hongpengWu/mlkem-polymul-rv32i-fpga/mainline/k4/skill/README.md

# Validation skill material

This directory contains the supplied PYNQ accelerator validation and overlay contract skill packages. They are auxiliary review and demonstration material; the hardware source and build entry points remain under `mainline/k4/`.
