hongpengWu/mlkem-polymul-rv32i-fpga/docs/ACCEL_KAT_AUTORUN.md

# KAT 无人值守续跑

更新时间：2026-10-26。当前方向是 **K=4 / ML-KEM-1024 主线，K=2 冻结历史对照，
K=3 后置扩展**；K4加速组和同板CPU-only对照均已完成145/145。旧“K3/K4 BaseMul移植后返回K2优化”队列已撤销。
自动续跑 `pqc-kat` 已按用户要求删除，不再周期性发送指令。本文件仅作为人工续接断点。
当前发布分支为 `last`；`24-2hp` 是历史开发分支，原始分支和冻结基线不改。

## 当前人工续接断点（2026-10-16）

板上验证已完成，本文件保留续接规则和历史断点说明，不再启动新的长任务。
加速组 `FULL_PASS 145/145` 证据在 `results/keccak_cpu/board/20261016_full145/`；
同板CPU-only/加速配对证据在 `results/k4/paired_firmware/board_20261023/`。
历史RTL、PS–PL和实板数据仍按证据层级分别引用。

## 已完成

- [x] 512 CPU+PQC：19 批、145/145 唯一覆盖，各批最终 PASS、实际 MMIO 指标和官方输出通过。
  缺失 0–37 已补齐，142–144 已按实际 3 条修复，不要重跑旧 14 批入口。
- [x] 独立证据位于 `results/accelerator_cpu/kat/`，默认 collector 通过；已提交推送 `0b16e76`。
  CPU-only / CPU+PQC 为 692,273,249 / 697,154,629 cycles，端到端 0.992998×。
  核心 46,240、搬入 14,404,780、读回 1,986,620、其余 API/驱动 680,716,989 cycles；后者不能全称轮询。
- [x] 768 RV32IM-fast CPU-only：2026-09-26 17:40 完成 145/145，collector 校验通过。
  算法周期 1,112,525,793，全程周期 1,147,835,590，最大观测栈 18,432 B。
  证据和表格在 `results/official_baseline/mlkem768/rv32im_fast/`。
- [x] K3/K4 参数化固件、fixture 和 TB 已建立，128 KiB RAM、32 KiB 栈。
  1024 RV32I/RV32IM 已编译；RV32IM-fast 官方 RTL 回归已 145/145 通过。

## 1024 RV32IM-fast CPU-only 已完成

- 已按 19 个顺序批次完成：0–7、8–15、…、136–143、144（最后 1 条）。
- 全量 collector 已通过：145/145 唯一覆盖，逐字节官方输出、返回值、M 指令、栈和输入哈希均通过。
- 汇总：算法 1,699,294,360 cycles，全程 1,747,426,461 cycles，最大观测栈 24,464 B；证据在 `results/official_baseline/mlkem1024/rv32im_fast/`。
- 每批证据：`results/official_baseline/mlkem1024/batches/rv32im_fast/batch_*/`。
  实时日志为 `console_<attempt>.txt`；`simulate.log` 可能缓冲至结束，不能因其为空误判停止。
- 构建目录：`build/mlkem_suite/1024/rv32im_fast/<batch>/<attempt>/`，重试使用新目录。
- 每批保存真实 case_count、original_indices、运行前输入哈希、最终 PASS 和 success.json；失败修复时保留旧 attempt。
  Windows 进程锁及活动 Vivado/XSim 检查防止重复调度。
- 新建 `build/mlkem_suite/STOP` 后，在当前批结束时停止启动下一批；恢复前移除标记。
  运行中禁止更改冻结脚本、TB、固件、manifest，禁止终止正常仿真或删除活动目录。

## 当前开发规则（2026-10-04）

- 优先完成K4主线；K3、其他CPU消融等支线后置。
- 日常迭代只跑官方子集（默认索引0、1、115，覆盖KeyGen/Encaps/Decaps）与针对改动的smoke/边界检查。
- 最终候选完成后再跑145条全量验收；子集不能记为145/145。
- 核心/HLS及独立PL流程使用`mainline/k4/flow.tcl`顶部0/1开关，默认`FULL_KAT=0`。
- PS–PL使用独立`mainline/k4/bd_axi.tcl`及`PREPARE/SIM/CREATE_BD/SYNTH/IMPL/EXPORT`开关；
  通过门禁后只发布到`release/mlkem1024_pynq/`，不新增并列部署目录。
- 每个RTL版本使用独立CANDIDATE结果目录；续跑先核对版本，旧结果只供对照。
- 主线稳定后统一整理目录、合并冗余入口；保留原始证据和所需冻结输入。

### PS–PL当前断点

`20261004_psaxi02`实际执行的AXI协议检查与官方索引0、1、115三例已PASS。
`20261004_psaxi04`因复位极性/辅助复位接线及GP0接口元数据问题拒绝作为发布候选；
run05也因GP0元数据拒绝，原证据保留。`20261005_psaxi06`已完成实现与发布，
setup/hold/pulse +0.302/+0.026/+3.750 ns，功能风险DRC为0，29,758条网络全部布线。
LUT/FF/BRAM36等效/DSP为19,759/17,585/34.5/4；配套文件与哈希校验通过。
固定部署目录`release/mlkem1024_pynq/`；项目`E:/hls/k4pynq/20261005_psaxi06/project/k4_pynq.xpr`。
恢复记录及7处隐式LUT配对布局修复见该批次reports；未改写冻结输入，无需重跑旧KAT。
K=4 PYNQ-Z2 overlay 已上传并完成 Notebook 官方全量 `FULL_PASS 145/145`。
实板原始证据位于 `results/keccak_cpu/board/20261016_full145/`；默认三例适合现场演示，全量 JSON 作为归档验收。
此前独立3例PL自检已有用户报告的LED0 PASS和BTN0复位后恢复；这不代替新overlay实测。

### 已冻结的核心断点

`timing_decode_v3`最终官方KAT **145/145** 已通过；19批最终PASS、唯一覆盖、
官方输出、冻结输入哈希和3,188次真实HLS调用已独立复核。API周期CPU/加速为
1,699,294,360 / 446,853,509，3.8028×；证据在
`results/keccak_cpu/candidates/timing_decode_v3/kat/`。断点complete，当前版本无需重跑。
调度日志`build/keccak_cpu/candidates/timing_decode_v3/final145_scheduler.log`；
冻结输入保留在`E:/hls/k4kat_timing_decode_v3/`，19批与板级共用的18项核心/HLS输入哈希一致。
`20261004_121837`完成布线后写DCP异常退出；保留失败证据，从综合检查点恢复实现。
恢复批次`20261004_124354`已保存最终DCP/报告：100 MHz内部setup/hold +0.269/+0.029 ns，
LUT19,003、FF17,005、BRAM36等效34.5、DSP4。全路径hold −1.194 ns仍在OOC resetn边界，
原始`timing_met=false`保留；板级签核已在独立真实MMCM流程完成。
上述145/145与3.8028×均是历史核心RTL证据，不转记为新PS–PL或实板性能。

板级上板前签核证据位于`results/keccak_cpu/board/20261004_162430/`：官方索引0、1、115
三例真实MMCM仿真通过，setup/hold/pulse为+0.109/+0.027/+2.000 ns，路由28,091/28,091，
功能风险DRC为0，bitstream位于`E:/hls/k4board/20261004_162430/board/board.bit`。

## 下一步顺序

1. [x] 1024 已执行 `python scripts/mlkem_suite/collect.py --parameter-set 1024 --write`。
   145 条唯一覆盖、每批最终 PASS、官方字节/返回值、M 指令、栈、周期和哈希全部通过。
2. [x] 更新性能表、覆盖矩阵、路线图。K3/K4 的128/32 KiB与512的64/16 KiB已分开列明。
   768 run_snapshot是事后归档：原run_inputs哈希仿真前捕获，额外源码只属事后快照。
   不改写历史哈希或伪称构建前证据。1024已补齐命令、源码、工具链和链接脚本哈希。
3. [x] 完成首轮 K=4 Keccak/FIPS 202 HLS 精确建模、访存优化和独立 IP OOC 实现。
   主加速器不受旧 BaseMul 范围限制；K=2 的 Keccak 71%–81% 占比只属于 K=2，K=4 尚未测量。
4. [x] K4主机145条官方记录调用统计已完成；CPU＋Keccak接口10次真实RTL调用/216字通过。
   见 [接口与移植断点](MLKEM1024_KECCAK_CPU_INTERFACE.md)。
   [x] 已完成标准库FIPS202适配、固件编译及完整官方RTL KAT145/145。
   官方加速系统入口为`mainline/k4/scripts/run_kat.py`，续跑加`--remaining`，
   日志/证据独立保存在`results/keccak_cpu/kat/`，短路径冻结项目在`E:/hls/k4kat/`。
   当前进程/断点读取`build/keccak_cpu/kat_progress.json`；不要再运行CPU-only批次。
   全部145条唯一覆盖、19批最终PASS、3,188次真实HLS调用（含68次SQUEEZE）均通过。
   当前调度日志`build/keccak_cpu/kat_scheduler_20260927.log`；无定时任务。
   调度器已运行`collect_kat.py --write`严格汇总，人工只读复核也通过；状态complete，无需再启动。
   主机、纯 CPU、局部 `hashlib` 差分或软件回退均不能替代对应加速系统的官方验证。
5. [x] 完成同RV32IM-fast、128 KiB RAM / 32 KiB栈的完整API对照：
   1,699,294,360 / 446,853,509 cycles，3.8028×，包含搬运、启动、等待和读回。
   [x] 已完成同约束完整系统OOC实现，报告在`results/keccak_cpu/system_impl/20260927_194022/`，DCP保留在`E:/hls/k4sys/20260927_194022/`。
   两组资源足够；CPU-only内部setup/hold +1.452/+0.051 ns，加速组 −1.367/+0.050 ns。
   [x] 当前v3已解耦程序RAM写控制和adapter ready反馈、简化MMIO译码，组件/子集/同例周期通过；原145条证据不改写。
   [x] 当前v3内部100 MHz时序已通过；完整布线与pulse width检查通过。
   [x] 完成板级边界/时钟复位集成、3条官方子集、实现签核和bitstream；当前核心最终145条已验收。
   板级setup/hold/pulse +0.109/+0.027/+2.000 ns；独立3例实板自检由用户报告LED0/BTN0通过。
6. [ ] K=4 主线完成后再验证 K=3 扩展和其他 CPU 消融；K=2 历史对照继续冻结。
7. [x] 当前核心145条验收完成；组件错误返回和板级运行中复位恢复检查通过。
8. [x] PYNQ-Z2独立3例自检：用户报告LED0 PASS及BTN0复位后恢复；无PS/AXI主机读回。
9. [x] 新PS–PL overlay：run02实际AXI协议及3例PASS；run06物理签核和部署包校验通过。
10. [x] PYNQ-Z2 Jupyter 装载、周期/结果读回、证据导出及官方145条全量实板运行通过。
11. [x] 2026-10-23完成同条件CPU-only固件、成对Notebook、14项主机检查与真实RTL切换7/7；
    `results/k4/paired_firmware/rtl_01/`保留三次128 KiB全镜像回读与官方输出证据。
    [x] 用户已运行新Notebook并回传ZIP；两组各145条、60次代表例重复及6项恢复专项通过。
    独立复核原始输出、输入、artifact/全RAM哈希及硬件计数；API 3.802806×、PS整批2.297581×。
    证据在`results/k4/paired_firmware/board_20261023/`，无需重跑，下一步为报告定稿与演示演练。

## 当前 K=4 HLS 进展及证据边界

- 目录 `mainline/k4/hls/` 支持 SHAKE128/256、SHA3-256/512；32-bit BRAM 输入/输出
  为 2048/4096 B，26 个 `uint64` 上下文，命令为 HASH/SQUEEZE/CLEAR。
- io0、io1 均已完成 C 仿真与 Verilog COSIM 的 109 笔本地 `hashlib` 差分事务，
  这不是ML-KEM-1024官方KAT；另有CPU组件闭环10项及完整CPU+Keccak官方145/145通过。
- 所选 `opt02` 优化版全 TB 实测 75,280 cycles，对照基线 1,314,553 cycles。HLS 优化版估算
  LUT/FF/BRAM18K/DSP = 15,244/15,385/2/0、时钟 8.895 ns；基线为
  14,612/17,008/2/0、8.622 ns。全 TB 周期不能直接当作完整 ML-KEM 加速比。
- 独立 IP `opt01` OOC 布局布线已通过当前10 ns时钟约束：WNS/WHS +0.279/+0.098 ns，
  LUT/FF=16,885/15,320，外部存储与CPU未计入；完整系统OOC现已测得加速组setup −1.367 ns。`opt02` 只修正 LOOP_TRIPCOUNT
  上界且周期/资源相同，RTL 对比随报告归档。细节见 [HLS 说明](../mainline/k4/hls/README.md)
  和 [结果汇总](../results/hls/mlkem1024_keccak/summary.md)。

## 检查规则

不会自动重建定时任务。下列检查规则用于用户授权的后续工作：
先读本文件，再查 vivado/xsim/xsimk/xelab/xvlog 和日志；
正常推进时静默结束，避免重复分析。
Read-Host、外层PowerShell存在、RUN_FINISHED不是成功判据。仅阶段完成、失败或需用户操作时通知。
可修复问题自主处理。历史可见控制台曾因文本选择暂停，Escape后恢复；当前stdout写日志。
CPU时间增长和有效ROW是进度证据，最终成功仍须PASS。
