hongpengWu/mlkem-polymul-rv32i-fpga/docs/PROJECT_STATUS.md

# 项目进度与执行记录

更新时间：2026-10-26。本页汇总已完成工作、当前覆盖范围和下一步；详细数值以
[BENCHMARKS.md](BENCHMARKS.md) 和对应原始日志为准，长期阶段门见
[COMPETITION_ROADMAP.md](COMPETITION_ROADMAP.md)。

## 2026-10-14 目录重组（last分支）

竞赛报告母稿已整理为 [COMPETITION_REPORT.md](COMPETITION_REPORT.md)，图示、证据边界
和板级 TODO 均集中维护于该文件。

K4源码、固件、TB、约束与Notebook迁到 `mainline/k4/`；两个人工维护的Tcl入口为
`flow.tcl`、`bd_axi.tcl`。工具路径改为PATH/环境变量发现，项目依赖以脚本位置解析。
旧历史结果和发布包保持原样；迁移验证不替代既有全量验收或实板验证。
验证结果及路径映射见 [results/reorganization](../results/reorganization/)。

## 最新执行状态：K=4 同板配对正确性与性能验证完成

2026-10-23用户运行配对Notebook并回传原始ZIP，独立复核已通过：

| 验收项 | 实板结果 |
|---|---|
| CPU-only / CPU+Keccak官方记录 | 两组各145/145，逐字节输出与返回码一致 |
| API周期总和 | 1,699,293,290 → 446,852,439，**3.802806×** |
| PS整批墙钟 | 22.135448812 → 9.634239928 s，**2.297581×** |
| 三种操作重复 | 每模式0/1/115各10次，共60次通过；固定例周期无波动 |
| 控制恢复 | 两模式各完成后复位、错误magic拒绝、主机超时后恢复，共6项通过 |
| 固件装载 | 8次完整128 KiB RAM读回哈希匹配 |

[原始ZIP、逐阶段JSON及独立复核结果](../results/k4/paired_firmware/board_20261023/summary.md)
已归档。CPU-only的硬件启动/busy/缓冲读写全部为零；加速组3188次HLS启动匹配官方负载。
性能比较固定同一bitstream、RV32IM-fast、100 MHz、128 KiB RAM / 32 KiB栈和编译条件，
不再缺少同板CPU-only数据。PS墙钟包含传输/轮询/校验，固件切换、JSON写盘和网络传输另计。

**竞赛报告的核心功能、性能和实现数据已经齐备**，已填入报告母稿。接下来是正式排版、
图表和现场演示演练；功耗/能耗需要仪器，长期稳定性、侧信道与ARM对照属于后续扩展。

### 历史加速组首次全量实板验收

2026-10-16，`mlkem1024_pynq_work` overlay 在 PYNQ-Z2 上完成官方记录
`FULL_PASS 145/145`。覆盖索引 `0..144`，真实测量类型为 `PYNQ_BOARD_AXI_LIVE`；
板上 API 周期总和为 **446,852,439 cycles**，批量墙钟约 **9.563 s**。
逐条输出、返回值、输入身份和硬件计数保存在
`results/keccak_cpu/board/20261016_full145/board_full_20261016.json`，证据 SHA-256 为
`2b90b932ceaccfa7e148d6143deb398c58b961e78811741b4b871c907fb38934`。

独立 `verify.py` 再次确认 145 条唯一覆盖、官方输出/返回值、3,188 次 HLS 启动和
缓冲区计数。该结果是加速 overlay 的真实功能与周期实板证据；当时尚无CPU-only实板对照。
本轮配对测量另行归档，保留两次原始值；官方向量通过不代表 CAVP 认证。

### 配对版本准备与验收记录

2026-10-23恢复 SSH 上传通道后，先完成准备与上传，由用户在 Jupyter 运行并回传证据。
已有加速组145条原始证据继续保留；新一对测试已补齐同板性能对照。

1. **已构建两组匹配固件**：`build/k4/paired_20261023/{cpu_only,accelerated}/`。
   共用 `ps_kat.c`、链接脚本、RV32IM/O3、同版本库与编译器、128 KiB RAM / 32 KiB栈。
   CPU-only ELF只含软件FIPS202，Keccak MMIO符号不存在；加速镜像与原发布镜像字节相同。
2. **一键 Notebook 已完成**：同一 bitstream、100 MHz，CPU复位期间写入完整128 KiB固件，
   全部RAM读回并核验SHA-256后才运行。默认两组各145条、0/1/115各10次重复，
   完成后复位、非法magic、短超时恢复三项专项；逐阶段保存成功和失败JSON并提供ZIP下载。
   14项主机测试与Notebook模拟整流程通过，Python3.6语法检查通过；模拟不作为实板数据。
3. **真实RTL子集7/7通过**：发布overlay原RTL/HLS保持冻结，加速三例→CPU-only三例→
   加速一例，三次128 KiB全镜像读回、官方输出及两组硬件计数全部通过。
   CPU-only三例为13,046,690 / 13,908,285 / 17,088,701周期、全部硬件计数为零；
   加速为3,120,941 / 3,841,521 / 4,658,615周期，切回后KeyGen周期一致。
   [原始RTL证据](../results/k4/paired_firmware/rtl_01/result.json)独立归档；未重跑旧145条RTL。
4. **实板配对已通过并独立复核**：两组官方145条、代表例重复、限定恢复专项全部通过，
   比值从本轮原始实测重算。固件装载、读回和JSON写盘单列；短超时仅证明主机
   deadline→复位→重新运行，不代表HLS忙时中途复位或长期可靠性。

若采用同一 bitstream 切换固件，结论是同硬件上启用/停用加速服务的性能对照，
不代表移除加速器后的资源或功耗差异。当前无定时任务。

**上传已完成**：板上目录 `/home/xilinx/jupyter_notebooks/mlkem1024_paired_20261023/`，
15个文件、4,798,034字节，全部通过远端读回SHA-256核对。
[上传回执及本次主机快照](../results/k4/paired_firmware/upload_20261023/receipt.json)已归档。
上传阶段未远程加载overlay或运行测试；随后用户自行运行Notebook并回传证据ZIP。
本次测试不需要重跑，原始ZIP SHA-256为
`830e7fbd94c1e8ca621203514bce866ed2c8efffb5ffe214ac19f8159a7d37e6`。

### 已完成的 PS–PL 实现

`20261004_psaxi02`已实际执行并通过AXI协议检查及官方索引0、1、115三例。
新路径包含PS可访问的双口RAM、单例输入/结果窗口及主机逐字节校验；
这属于新AXI候选的3例RTL覆盖，不能继承旧核心的145/145覆盖或实板加速比。

`20261005_psaxi06`已通过最终签核及部署包校验：100 MHz，setup/hold/pulse
为+0.302/+0.026/+3.750 ns，29,758/29,758条网络完成布线，功能风险DRC为0。
LUT/FF/BRAM36等效/DSP为19,759/17,585/34.5/4，分别占37.14%/16.53%/24.64%/1.82%。
配套`.bit/.hwh`、Notebook、驱动与145条向量已发布到固定目录；
[签核与哈希](../results/keccak_cpu/pynq/20261005_psaxi06/result.json)已归档。

此前run04/05因复位连接或GP0元数据被拒绝；原证据保留。run06复用了相同输入的run02仿真，
从已完成的综合/布线检查点恢复，修复7处工具生成的隐式LUT配对问题，仅移动FDRE，
逐项验证INIT和连接保持不变。恢复Tcl及实际collector另行记录哈希，没有改写冻结输入。
新 overlay 已完成 Jupyter 全量 145 条运行；默认三例仍适合作为现场快速演示。PS–PL使用独立`mainline/k4/bd_axi.tcl`的
`PREPARE/SIM/CREATE_BD/SYNTH/IMPL/EXPORT`开关，通过门禁后仅发布到
`release/mlkem1024_pynq/`；构建与恢复方式见[BUILD.md](BUILD.md#k4-pspl--jupyter入口)。

此前独立3例PL自检已有**用户报告的LED0 PASS及BTN0复位后恢复**。
该历史观察与本次自动采集的PS–PL结果分开记录；本次全量实板证据见上方归档。
Notebook和驱动已完成装载、校验、计时分项、全量运行与证据导出。

### 已冻结的核心与独立PL实现证据

`timing_decode_v3`官方RTL KAT **145/145** 已完成，19批唯一覆盖、每批最终PASS、
官方输出及冻结输入哈希通过独立collector复核。3,188次真实HLS调用与预期匹配。
同RV32IM-fast、128 KiB RAM / 32 KiB栈：CPU/加速API周期为1,699,294,360 / 446,853,509，
完整测试集比值 **3.8028×**；最大观测栈24,384 B。19批仿真时长合计10,961.816秒，非芯片执行时间。
[核心全量证据](../results/keccak_cpu/candidates/timing_decode_v3/kat/summary.md)独立保存，冻结版本无需重跑。
**145/145和3.8028×属于该核心的历史RTL证据，不是新overlay的实板测量。**

板级`20261004_162430`的100 MHz setup/hold/pulse为+0.109/+0.027/+2.000 ns；
LUT/FF/BRAM36等效/DSP为19,030/16,963/34.5/4，bitstream及报告哈希已复核。
19个KAT批次与板级共用的18项CPU/系统/HLS输入哈希全部一致。
核心145例使用邮箱RTL测试平台；板级固件内置3例，真实MMCM及运行中BTN0复位恢复已验证。
原OOC resetn边界负hold证据保留，不影响独立板级流程已完成的签核。

该bitstream是独立PL自检，仅时钟/按钮/LED端口，没有PS/AXI控制接口。
核心开发默认仍仅跑索引0、1、115，使用`mainline/k4/flow.tcl`顶部开关；PS–PL使用上文独立入口。
无周期自动任务。
以下2026-09-27段落保留历史数据；当前覆盖以本节及独立全量证据为准。

2026-09-27 决策：**ML-KEM-1024（K=4）为优化与展示主线，K=2 冻结为历史对照，
K=3 在主线完成后验证扩展。** 主加速器优先评估 Keccak/FIPS 202 主导工作量候选，
不受旧 BaseMul 范围约束。先按报告优化且保持逐位一致的 HLS，再完成打包/批量接口、
CPU 集成和 K=4 官方 RTL KAT，随后给出同 CPU、同 RAM 的未插桩端到端对照与系统
资源/时序，实板最后进行。K=2 的 Keccak 71%–81% 占比仅属于 K=2；K=4 占比尚未测量。

`mainline/k4/hls/` 已实现 SHAKE128/256、SHA3-256/512，32-bit BRAM 输入/输出
容量为 2048/4096 B，上下文为 26 个 `uint64`，支持 HASH/SQUEEZE/CLEAR。
io0、io1 均通过 C 仿真与 Verilog COSIM 的 109 笔本地 `hashlib` 差分事务；这不是
ML-KEM 官方 KAT。优化版全 testbench 实测 **75,280 cycles**，基线 **1,314,553 cycles**。
所选 `opt02` 版 HLS 估算 LUT/FF/BRAM18K/DSP 为 **15,244/15,385/2/0**，时钟 **8.895 ns**；
基线为 **14,612/17,008/2/0**、**8.622 ns**。独立 IP OOC 布局布线已完成：100 MHz、WNS/WHS +0.279/+0.098 ns，
16,885 LUT、15,320 FF；外部存储和 CPU 未计入，完整系统时序另见下文。`opt02` 相比 `opt01` 只修正长非对齐续读的 LOOP_TRIPCOUNT 上界，
周期/资源不变；物理证据来自 `opt01`，RTL 对比与归档说明见
[K=4 HLS 说明](../mainline/k4/hls/README.md) 与
[HLS 结果汇总](../results/hls/mlkem1024_keccak/summary.md)。

自动续跑 `pqc-kat` 已按用户要求删除，不再周期性发送指令。

### K4 调用分析与 CPU 接口闭环（2026-09-27）

主机端145条官方K4记录全部匹配，计得8,683次Keccak置换；映射为3,120个HASH和68个SQUEEZE，
输入最多1600B、单命令输出最多504B，现有HLS容量足够。这是调用统计，不是Pico阶段周期。
独立RV32IM-fast＋Keccak系统已通过10次RTL调用、216个结果字，真实HLS启动/完成均为10次。
覆盖四种模式、上下文交错、续取、CLEAR和两类错误返回；固件4888B，RAM/栈128/32KiB。
CPU调用周期合计72,287，硬件busy合计4,070，完整TB326,618；不作为完整KEM或加速比。

标准库FIPS202适配及官方加速RTL **145/145** 已完成，19批全部最终PASS且无重复/缺失。
同RV32IM-fast、128 KiB RAM / 32 KiB栈，API周期合计从 **1,699,294,360** 降至
**446,853,509**，所选测试集总周期比 **3.8028×**，计入打包、搬运、等待、读回及CPU清零。
KeyGen / Encaps / Decaps分别 **4.203× / 3.636× / 3.602×**；含私钥重建的Decaps为3.827×。
3,188次实际HLS启动/完成与预期一致（3,120 HASH＋68 SQUEEZE）；最大观测栈24,384 B。
19批运行时长合计7,056.986 s（约1小时58分，含编译/展开），没有重跑CPU基线。
证据见[加速官方KAT汇总](../results/keccak_cpu/kat/summary.md)。完整系统OOC资源检查已完成，LUT19,084、FF16,970、BRAM34.5、DSP4；100 MHz内部setup −1.367 ns，实板待验证。
详见[接口与移植断点](MLKEM1024_KECCAK_CPU_INTERFACE.md)、
[调用统计](../results/keccak_cpu/call_profile/README.md)、[CPU闭环证据](../results/keccak_cpu/smoke/README.md)。

### 已完成的 CPU 基线与 K=2 历史证据

2026-09-26：ML-KEM-768 和 ML-KEM-1024 的 RV32IM-fast CPU-only 官方记录均已逐字节通过
145/145。算法区间分别为 **1,112,525,793** 和 **1,699,294,360 cycles**，最大观测栈分别为
**18,432 B** 和 **24,464 B**；两组使用 **128 KiB RAM / 32 KiB 栈**，512 原基线仍为
64/16 KiB。K=2（ML-KEM-512）CPU+PQC 加速链路也已通过 145/145，端到端为 0.9930×。
K=4当前CPU+Keccak已145/145官方RTL通过，100 MHz板级实现签核完成；K=3硬件扩展后置。
证据见 [768 汇总](../results/official_baseline/mlkem768/rv32im_fast/summary.md)、
[1024 汇总](../results/official_baseline/mlkem1024/rv32im_fast/summary.md) 和
[自动续跑记录](ACCEL_KAT_AUTORUN.md)。

RV32IM-fast 已通过新总线桥执行 MMIO C 驱动，3 组输入的 768 个系数全部核对通过。
调用周期均为 48,632，包含搬入、启动、等待及读回；核心为 136 周期。标准库 native hook
及完整官方套件加速固件已编译链接通过，ML-KEM-512 官方 KAT 已完成 145/145，CPU-only
baseline 保持不变。当前端到端 CPU+PQC 为 0.9930×，说明功能闭环已建立但搬运/轮询开销
仍高于核心节省。详见 [CPU 接口验证](MLKEM512_CPU_ACCEL_SMOKE.md) 和
[加速 KAT 汇总](../results/accelerator_cpu/kat/summary.md)。以下独立实现数据不代表新 CPU
集成系统资源。

2026-09-25 完成新 K=2 BaseMul 的独立 MMIO/BRAM/BIST 路径：3 组、768 个系数的 RTL
核对及接口异常检查通过，BIST 两次完整运行和结果故障注入通过。Vivado 2024.2 在
100 MHz 下实现通过，WNS/WHS 为 **0.732/0.129 ns**，使用 **8 个 BRAM 原语、12 个 DSP**，
已保存 XPR、bitstream 和报告。CPU 最小闭环及标准库官方 KAT 也已通过；145 条记录的
CPU-only/CPU+PQC 对照显示端到端为 0.9930×。该 K=2 路径现冻结保存，作为接口开销的历史证据。

2026-09-25 新增 RV32IM 快速乘法独立 profiling：**145/145 条记录、19/19 个批次通过**。
各阶段独占周期之和逐例等于 API 总周期，官方输出、返回值、M 指令和内存边界核验通过。
KeyGen / Encaps / 展开私钥 Decaps 的 Keccak 占比分别为 **80.69% / 72.96% / 71.36%**，
多项式算术合计为 **13.08% / 19.13% / 21.38%**；插桩对主要 API 的扰动约 +0.13%–+0.15%。
原基线保持不变。完整表、测量方法与接口任务见 [阶段分析报告](MLKEM512_PROFILE.md)。

K=2 标准库与旧核的运算域、缩放和缓存向量乘加接口已经审计，BaseMul HLS 及独立
MMIO/BRAM 路径已验证。这些结果说明核心周期改善不能替代端到端收益；K=4 的加速
范围和结构仍须由自己的报告、调用负载及系统测量决定，其他 CPU 消融后补。

2026-09-24 已完成三组 PicoRV32 CPU 配置的 145 条固定版本官方 ACVP 记录。每组均逐字节核对输入、输出和 API 返回值，并核对实际 `rdcycle` 区间、动态 M 指令计数、栈边界和工程输入哈希；错误输出负向检查也通过。结果是 RTL 仿真证据，不是实板数据或正式 CAVP 认证。

| 配置 | 已通过 / 总项数 | 总算法区间周期 | 全部算法区间 M | 最大观测算法栈 |
|---|---:|---:|---:|---:|
| RV32I | 145 / 145 | 1,400,566,832 | 0 | 12,928 B |
| RV32IM 迭代 | 145 / 145 | 812,132,449 | 3,486,720 | 12,928 B |
| RV32IM 快速 | 145 / 145 | 692,273,249 | 3,486,720 | 12,928 B |

全量结果见 [ML-KEM-512 汇总](../results/official_baseline/mlkem512/summary.md)、[结构化数据](../results/official_baseline/mlkem512/summary.json) 和 [逐条记录](../results/official_baseline/mlkem512/cases.csv)。结果由关机前保存的 94 条记录与 44 个独立批次合并；每条原始 `case_index` 恰好一次，未拼造单次全套 PASS。由于旧前缀没有最终 PASS，summary 中整套启动总周期和整套全程 M 保持不可用；上表只列全部 API 算法区间的真实累加值。

## 1. 已确认的项目方向

**ML-KEM-1024 是当前主线；ML-KEM-512 保留历史对照；ML-KEM-768 后置扩展。**
纯 CPU 软件 baseline 已由真实 PicoRV32＋BRAM RTL 执行固件验证。K=2 加速通过记录
和独立实现均保留，但不能用于证明 K=4 CPU+加速器系统的正确性、性能或资源。

| 工作范围 | ML-KEM-1024（K=4） | ML-KEM-512（K=2） | ML-KEM-768（K=3） |
|---|---|---|---|
| NIST 安全类别与定位 | 5，优化与展示主线 | 1，冻结历史对照 | 3，后置扩展 |
| 官方公开向量正确性回归 | fast CPU及当前CPU+Keccak各145/145，历史证据保留 | 三种 CPU 各 145/145；加速 145/145 | fast CPU 145/145；加速扩展待测 |
| CPU 基本性能与内存 | 128 KiB RAM / 32 KiB 栈；阶段占比待测 | 64 KiB RAM / 16 KiB 栈；已完成阶段分析 | 128 KiB RAM / 32 KiB 栈；保留已测数据 |
| 加速器优化 | 报告驱动 Keccak/FIPS 202 HLS，随后批量接口与集成 | 保留 BaseMul 0.9930× 对照，不继续主线扫参 | 在 K=4 最终架构上验证兼容性 |
| 设计空间与资源权衡 | 逐位等价、Core/Call/API 周期和系统资源/时序 | 历史证据 | 后置代表性结果 |
| 最终应用展示 | 主要展示对象，实板最后 | 历史对照 | 扩展功能证据 |

三参数集每个多项式都为 256 个系数，模数均为 3329；向量维度分别为 2、3、4，
并有采样和压缩参数差异。K=4 的平台取舍须由测得的延迟、存储和实现资源支撑；
不得把 K=2 阶段占比或独立加速器实现数字直接套到 K=4。
主线不针对固定 KAT 输入特化；同时支持三个 ML-KEM 参数集也不等于支持多个密码算法。

## 2. 当前完成情况

| 工作项 | 当前状态 | 证据或入口 |
|---|---|---|
| 仓库整理与 Vivado 2024.2 重建入口 | 已完成；保留当前源码、必要 TB/Tcl、CPU-only 与独立加速器 XPR/bitstream | [目录规则](STRUCTURE.md)、[构建说明](BUILD.md) |
| PicoRV32 迭代 M 扩展验证 | 已通过 8 类 M 指令共 4096 项检查；三组 CPU baseline 回归通过 | [CPU baseline 证据](../results/cpu_baseline/) |
| ML-KEM-512 baseline 与阶段分析 | 三组基线离线分析完成；快速乘法 profiling 全部 145 条通过 | [基线解释](MLKEM512_BASELINE_ANALYSIS.md)、[阶段分析](MLKEM512_PROFILE.md) |
| 纯 CPU 多项式软件 baseline | RV32I、RV32IM 迭代、RV32IM 快速均完成 8 组输入检查及周期测量 | [CPU baseline 结果](../results/cpu_baseline/) |
| 旧 16 KiB CPU baseline 实现 | 三组已完成综合、布局布线、资源/时序报告和 bitstream；本轮未做实板复验 | [性能台账](BENCHMARKS.md) |
| 官方向量与参考实现冻结 | 已记录 ACVP 来源、提交、SHA-256 和参考实现版本 | [向量来源](../vectors/official_kat/acvp/SOURCES.md) |
| 电脑主机上的标准参考回归 | 512/768/1024 合计 435 项通过；包含不同操作和检查类型 | [主机结果](../results/official_reference/) |
| PicoRV32 ML-KEM-512 官方全集 | 三种 CPU 各 145 条通过，覆盖六类操作、两类密钥检查的有效/无效结果及隐式拒绝 | [全量汇总](../results/official_baseline/mlkem512/summary.md) |
| 输入、输出和执行真实性检查 | 每组核对 148,160 B 输入和 101,760 B 输出；检查实际 rdcycle、M 指令、栈和异常 | [验证记录](VALIDATION.md) |
| 错误输出拒绝检查 | 临时预期公钥首字节翻转后，被全量 TB 准确拒绝 | [负向检查](../results/official_baseline/mlkem512/negative_check/README.md) |
| 标准软件的完整 CPU baseline | 512 API/阶段分析和768/1024 RV32IM-fast CPU全集完成；K4阶段占比、其他CPU消融待测 | [M2 路线](COMPETITION_ROADMAP.md#m2picorv32-完整软件-baseline) |
| K=2 标准库接口审计与历史 HLS 原型 | C 仿真 103/103、HLS 综合通过；137 cycles 为核心估算，II=1、估算 Fmax 150.83 MHz | [接口契约](MLKEM512_ACCELERATOR_INTERFACE.md)、[K=2 HLS](../hls/mlkem512_basemul_k2/) |
| 独立 MMIO/BRAM/BIST 与 Vivado 实现 | RTL 3 组、768 个系数及接口检查通过；核心实测 136 cycles；BIST、100 MHz 实现和 bitstream 已完成 | [RTL 证据](../results/accelerator_interface/rtl_sim/)、[实现报告](../results/accelerator_interface/vivado_impl/) |
| K=2 PQC 加速器接入标准软件 | 冻结历史对照；CPU+驱动及官方 KAT 145/145 通过，端到端 0.9930× | [CPU 接口验证](MLKEM512_CPU_ACCEL_SMOKE.md)、[KAT 汇总](../results/accelerator_cpu/kat/summary.md) |
| K=4 Keccak/FIPS 202 HLS | io0/io1 的 C 与 Verilog COSIM 均通过 109 笔本地差分事务；独立 IP OOC 实现已完成，当前100 MHz板级实现签核完成 | [HLS 说明](../mainline/k4/hls/README.md)、[结果汇总](../results/hls/mlkem1024_keccak/summary.md) |
| K=4 CPU+加速器核心与独立PL自检 | 冻结核心145/145、历史RTL比值3.8028×；独立PL实现签核完成，用户报告3例LED0 PASS及BTN0复位恢复 | [独立PL证据](../results/keccak_cpu/board/20261004_162430/result.json) |
| K=4 PS–PL / Jupyter overlay | PYNQ-Z2 实板官方 145/145 `FULL_PASS`；446,852,439 API cycles；约9.563 s批量墙钟 | [实板全量证据](../results/keccak_cpu/board/20261016_full145/README.md) |

### 当前官方用例覆盖

| 执行环境 | ML-KEM-512 | ML-KEM-768 | ML-KEM-1024 |
|---|---|---|---|
| 电脑主机参考实现 | 145 项所选记录通过 | 145 项所选记录通过 | 145 项所选记录通过 |
| PicoRV32 RV32I RTL | 145 项所选记录通过 | 待测 | 待测 |
| PicoRV32 RV32IM 迭代 RTL | 145 项所选记录通过 | 待测 | 待测 |
| PicoRV32 RV32IM 快速 RTL | 145 项所选记录通过 | 145 项通过，128 KiB RAM | 145 项通过，128 KiB RAM |
| CPU＋PQC 加速器标准软件 | 145 项 RTL 仿真通过；端到端 0.9930×，冻结历史对照 | 后置扩展 | 冻结核心145项RTL通过，历史API周期比3.803×；新AXI候选3例通过 |
| 本项目标准软件实板回归 | 后置 | 后置 | K=4同板两组各145/145；API 3.802806×，PS整批2.297581× |

主机的 435 项是 `75 + 165 + 195`，来自固定版本 FIPS203 keyGen、FIPS203 encapDecap
和 FIPS203-tr1 encapDecap 数据集。历史 PicoRV32 的 435 次执行是同一512集合在三种CPU上各145项；
另有768/1024 fast CPU各145项，这是CPU-only覆盖；K4加速系统另有独立145项RTL证据，K3加速扩展待测。
每参数集为 `25 + 55 + 65 = 145` 项记录，其中包含密钥检查，不能统称 145 次完整 KEM。
后续按数据集/修订、操作、参数集、tgId、tcId 登记覆盖，保留检查型用例与运算型用例的区别。

### 历史 KeyGen 首例测量快照

| CPU 配置 | KeyGen 周期 | 按 100 MHz 换算 | 相对 RV32I | 动态 MUL |
|---|---:|---:|---:|---:|
| RV32I | 8,995,082 | 89.95082 ms | 1.0000× | 0 |
| RV32IM 迭代 | 5,812,531 | 58.12531 ms | 1.5475× | 18,176 |
| RV32IM 快速 | 5,194,547 | 51.94547 ms | 1.7316× | 18,176 |

这三个结果各来自一个用例的一次确定性 KeyGen 调用，包含库内默认清零，排除启动、
种子准备、熵源采集、调试传输和 TB 检查；空计时区间 4 周期不扣除。
该历史单例表不表示完整 KEM 耗时或 PQC 加速器加速比；当前通用驱动的完整用例分布
见上方 512 全量汇总，其操作分派和外围指令与旧首例驱动不同。

历史首例三组统一 64 KiB RAM、16 KiB 栈预留，观测栈使用 9,328 B，RV32I/RV32IM
有效镜像分别为 19,424 / 18,848 B。当前全量驱动的对应镜像为 27,808 / 26,272 B，
全部 145 条的最大观测算法栈为 12,928 B，仍保留同样的 RAM 和栈容量；观测值不是最坏输入上界。
原 16 KiB 多项式工程的资源与 bitstream 不能作为新配置的实现证据；
100 MHz 是仿真时钟换算，新配置的布局布线频率和资源仍待测。

## 3. 接下来的执行顺序

| 顺序 | 任务 | 完成标志 | 当前状态 |
|---|---|---|---|
| 1 | 保存 K=2 历史对照和 K3/K4 CPU 基线 | 原始日志、配置、哈希及内存差异可追溯 | 已完成 |
| 2 | K=4 报告驱动的精确 HLS 优化 | 保持 FIPS 202 逐位结果；C/COSIM、周期、资源和时序报告完整 | io0/io1局部差分及当前100 MHz板级实现签核完成 |
| 3 | K=4 打包接口与 CPU 集成 | 明确上下文、搬运、启动、等待和读回契约 | 10次RTL组件调用通过，标准库适配完成 |
| 4 | K=4 CPU+加速器官方 RTL KAT | 开发子集，最终145条逐字节通过且真实硬件调用证据完整 | 冻结核心145/145；新AXI候选run02协议及3例PASS |
| 5 | K=4 未插桩端到端公平对照 | 同 RV32IM-fast、128 KiB RAM / 32 KiB 栈，完整 API 周期含接口成本；阶段占比独立测量 | 同板API 3.802806×、PS整批2.297581×；更细K4阶段占比后置 |
| 6 | K=4 系统资源/时序与设计选择 | 同约束软件/硬件综合和布局布线，记录 LUT/FF/BRAM/DSP/WNS；独立 HLS 估算不替代系统结果 | 板级setup/hold/pulse +0.109/+0.027/+2.000 ns；19,030 LUT、16,963 FF、34.5 BRAM36、4 DSP |
| 7 | K=3 扩展和其他 CPU 消融 | 在选定架构上补齐对应官方回归、基本性能和内存数据 | 后置 |
| 8 | 完成上板前验收 | 系统回归、适用异常/故障检查、实现时序与匹配烧录产物准备完毕 | 已完成 |
| 9 | PYNQ-Z2 实板和演示 | 功能、周期读回及适用板级功耗数据，与仿真/实现证据对应 | 两组官方145/145、60次重复、6项恢复与同板加速比完成；演示演练及可选功耗待补 |

K=2 不再进入主线优化队列；K=3 无需重复 K=4 的每一轮扫参，但扩展必须有独立硬件证据。
若不同参数集使用不同内存容量，报告中需明确，不能把不同配置的结果当作只改变算法参数的对照。

## 4. 对外表述与证据边界

当前可表述为：

> 固定版本参考实现在主机上通过 435 项 NIST ACVP 官方公开向量回归；三种 PicoRV32
> 配置在 RTL 仿真中均通过全部 145 条固定版本 ML-KEM-512 官方记录。ML-KEM-768/1024
> 的 RV32IM-fast CPU-only 官方记录也分别通过 145/145；K=2 的 BaseMul 独立
> MMIO/BRAM/BIST、Vivado 2024.2 实现及 CPU+PQC 全流程已完成并冻结。当前主线是
> K=4 Keccak/FIPS 202：局部 HLS 的 C/Verilog COSIM 差分通过，独立 IP OOC 实现已完成，当前100 MHz板级实现签核完成；
> 历史版本CPU组件10项及标准库145条官方RTL记录已通过，同配置测试集API总周期比3.803×；
> 冻结核心官方145/145及独立PL实现签核完成，setup/hold/pulse为+0.109/+0.027/+2.000 ns；
> 独立3例PL自检由用户报告LED0 PASS及BTN0复位恢复。新PS–PL run02实际AXI协议及3例通过，
> 新 overlay 已在 PYNQ-Z2 上完成官方145/145；实板 API 周期总和为446,852,439，
> 批量墙钟约9.563秒。历史3.8028×仍不作为实板加速比，因为同配置 CPU-only 尚未上板对照。K=3扩展后置。

全部对应回归完成后，可以描述所覆盖版本、参数集、操作和用例的结果一致性。
公开向量离线回归不等于正式 CAVP 算法验证，也不等于 FIPS 140-3 / CMVP 密码模块认证；
测试通过不能单独证明所有合法输入下完全正确、恒定时间或侧信道安全。

## 5. 文档维护与本次记录

- 当前进度和下一步：本文件。
- 目标、范围与长期验收门：[COMPETITION_ROADMAP.md](COMPETITION_ROADMAP.md)。
- 性能/资源详细台账：[BENCHMARKS.md](BENCHMARKS.md)；原始证据在 `results/`。
- 命令与操作：[BUILD.md](BUILD.md)；验证范围：[VALIDATION.md](VALIDATION.md)。

以下记录保留各阶段完成时的范围和当时计划；2026-09-27 的 K=4 主线决策取代旧方向，
下文“下一步”不再代表当前队列。提交状态以 Git 为准。

2026-09-24 决策：确定“512 重点优化、768/1024 正确性与扩展验证”，实板放在上板前工作之后。
本次保留关机前 94 条记录，完成其余 341 次执行的 44 个批次，并经严格汇总确认三组各 145 条。
逐例日志、映射、输入哈希和便携工程证据已保存；未进行 64 KiB 实现、加速器集成或实板测试。
本轮未提交 Git，提交状态以工作区为准。

2026-09-25：独立插桩镜像完成 19 批、145 条 RTL 回归；正式软件基线、第三方库、CPU/HLS
原文件保持不变。阶段 CSV、完整统计、构建与批次哈希已归档，新增可断点续跑入口。
未进行新综合/实现、硬件接入或实板操作，修改仍未提交。

2026-09-25（CPU 接入前快照）：完成标准库/加速器接口审计；旧 HLS 明确标记为 legacy baseline。新建
`hls/mlkem512_basemul_k2/`，以独立 testbench 覆盖零值、规范值、signed lazy 边界和
100 组确定性随机输入，C 仿真 103/103 通过；Vitis HLS 2024.2 短路径综合通过，得到
137 cycles、II=1 和估算 Fmax 150.83 MHz；该快照当时尚未进行完整 Vivado 工程接入、
AXI 适配、CPU 接入或官方 KAT 硬件回归，后续记录已补充这些结果。

2026-09-25 后续：独立 MMIO/BRAM/BIST 验证与 Vivado 实现完成，交付 bitstream 保存在
`release/mlkem512_basemul_k2/`，实现报告和验证证据保存在 `results/accelerator_interface/`。
当时的 `vivado/mlkem512_basemul_k2/basemul.xpr` 是本地生成工程；XPR/MEM 不随仓库克隆，
需通过构建脚本重建后才能在 Vivado 中直接打开。现有 CPU baseline 保持不变；RV32IM-fast 的
145 条 ML-KEM-512 官方 KAT 已计入搬运、等待和读回成本，结果为 CPU+PQC 697,154,629
cycles 对 CPU-only 692,273,249 cycles（0.9930×）。下一步应降低接口开销，再开展
768/1024 扩展和新的实现对照。
