hongpengWu/mlkem-polymul-rv32i-fpga/results/keccak_cpu/board/20261004_143831/REVIEW.md

# 首轮板级实现：复核未通过

本目录为2026-10-04首轮原始证据，保持不变。`result.json`和`board_signoff.json`
中的`passed=true`来自当时不完整的自动门禁，**不代表最终接受，不使用此轮bitstream交付**。

真实MMCM、忙时按键复位及三条官方记录的RTL仿真通过；布线后setup/hold为
+0.124/+0.031 ns。但复核发现：

- REQP-1839/1840：异步清零寄存器直接影响BRAM控制/地址，存在复位期间存储损坏风险。
- Designutils 20-1307及Constraints 18-402/18-513：XDC的过程式检查和LOCKED起点例外未正确应用。
- PDRC-132/134/136/138/146：物理优化后的双LUT方程警告尚未解决；CHECK-3提示部分报告计数截断。

后续候选增加同步系统复位输出级，把端点检查移到实现Tcl，仅约束4个CLR端点，
并使用显式物理优化选项排除默认LUT合并。门禁也增加上述规则和全部工具Critical Warning检查。
修正版本使用新的冻结目录重新仿真和实现，不改写本目录历史结论或哈希。

首轮本地bitstream：`E:/hls/k4board/20261004_143831/board/board.bit`，
SHA-256：`9803feb7c63f51e6b30dd00b13561c7c80b53c70118ba6ca47af336ca8520d57`。
仅保留作失败迭代证据；未执行烧录或实板测试。
