hongpengWu/mlkem-polymul-rv32i-fpga/results/k4/candidates/structure_check/kat/summary.md

# ML-KEM-1024 CPU + Keccak official KAT

Status: **PARTIAL**, 3/145 unique official cases.

PicoRV32 fast CPU plus real generated Keccak RTL, official K4 cases; not board measurement or certification.

Raw rdcycle API intervals including CPU/MMIO work and zeroization; empty bracket retained; seed decapsulation includes key expansion. Busy cycles measure HLS activity; remaining API cycles also include transfers and CPU work, not pure transfer overhead.

| Operation | Return | Cases | CPU cycles | Accelerated cycles | Ratio of sums |
|---|---:|---:|---:|---:|---:|
| decapsulation | 0 | 1 | 17088709 | 4658623 | 3.668x |
| encapsulation | 0 | 1 | 13908293 | 3841529 | 3.621x |
| keyGen | 0 | 1 | 13046698 | 3120949 | 4.180x |

API cycle sums: CPU 44,043,700; accelerated 11,621,101; ratio **3.789977x**. This ratio applies to this official case mix.

Hardware commands: 85 starts, including 4 continuation squeezes. HLS busy: 51,913 cycles. Buffer transfers: 6,703 writes / 11,548 reads, in 32-bit words including context.

Completed batches: 1. Run-duration sum: 302.594 s. Sum of individual simulator run durations, including compilation/elaboration; not uninterrupted wall elapsed time.

Maximum observed stack: 24,384 bytes, from verified final PASS records; not a worst-case bound.

Only successful, hash-verified, disjoint attempts are included. Every result checks official identities, byte counts, returns, CPU configuration, measured boundaries and exact expected hardware command/transfer counts.

Strict recollection requires every manifest run_dir/snapshot directory, retained outside Git. Log and manifest hashes alone cannot reconstruct frozen firmware, testbench or generated HLS inputs.

This pilot does not establish full 145-case RTL coverage. Selected original indices: [0, 1, 115].
