hongpengWu/mlkem-polymul-rv32i-fpga/results/k4/paired_firmware/README.md

# 同板固件配对验证与上传记录

2026-10-23，沿用已发布的PYNQ-Z2 bitstream，准备同CPU、时钟、RAM、编译器、库和API
边界的CPU-only/CPU+Keccak对照。用户已运行并回传实板证据，独立复核通过。

- `rtl_01/`：7例真实RTL输出、三次完整128 KiB镜像写入/回读、原始日志及冻结输入。
  加速0/1/115 → CPU-only0/1/115 → 加速0，全部通过；CPU-only全部硬件计数为零。
- `upload_20261023/`：发布manifest、驱动、Notebook、14项主机测试输出及上传回执。
  15个文件全部远端读回SHA-256一致；未加载overlay，未运行实板测试。
- `board_20261023/`：随后用户运行产生的原始ZIP、逐阶段JSON和独立复核；
  两组各145条、60次代表例重复和6项控制恢复通过。API 3.802806×、PS整批2.297581×。
- `build/k4/paired_20261023/`保留完整固件编译产物；`build/transfer/mlkem1024_paired_20261023/`
  为电脑端配对部署包。bitstream/HWH和官方向量沿用既有发布包，原件未改写。

Notebook默认两组各145条、0/1/115各10次和三类恢复专项，本轮由用户自行运行完成。
所有阶段原始JSON自动保存并提供ZIP下载。主机模拟测试不计作RTL或实板正确性证据。
同一bitstream保留加速器，因此未来测得的比值表示启用加速服务的效果，不代表面积/功耗消融。
