hongpengWu/mlkem-polymul-rv32i-fpga/results/official_baseline/mlkem512/checkpoint/README.md

# 关机暂停断点

保存时间：2026-09-24 20:14:23（本地时间）。用户因急事需要关闭电脑，正常全量回归已停止。
这是逐用例断点，不是 XSim 进程/寄存器快照；正在计算但尚未输出完整 ROW 的用例需要重跑。

| 配置 | 已通过 | 下一原始 case_index（从 0 开始） | 剩余 |
|---|---:|---:|---:|
| RV32I | 25 / 145 | 25 | 120 |
| RV32IM 迭代 | 31 / 145 | 31 | 114 |
| RV32IM 快速 | 38 / 145 | 38 | 107 |

三组共完成 94 次用例执行，没有发现功能失败。每个保存的 ROW 均由 TB 在完成
本例输入、输出、返回码、周期等检查后打印。未完成整个配置，因此没有伪造最终 PASS 标记。

- `checkpoint.json`：每组下一位置、数量和 CSV 哈希。
- `<config>/completed_rows.csv`：已完成用例的真实数据。
- `<config>/partial_console.txt`：停止前保存的原始控制台记录。
- `<config>/run_inputs.json`：该次仿真启动前冻结的输入哈希。
- `inputs/`：对应实际输入文件的快照，保留旧 TB/脚本/固件/fixtures，供恢复后验证来源。

## 恢复时的工作

当前原始 `run.py` 从头运行全套，尚无续跑参数，恢复时不要直接执行它而覆盖本次记录。
下次由代理先添加按剩余用例生成批次的入口，然后再启动仿真：

1. 校验已保存 CSV 与快照 SHA-256，并逐行对应官方 case 身份。
2. 保持同一固件和 CPU/内存配置，只从官方 fixture 提取各组剩余输入与预期结果。
3. 通用固件已接受 1..145 项；新批次将本地 index 从 0 编号，另存与原始 index 的映射。
   TB 需要允许批次长度，且仍严格检查每例结果；保留本次原 TB 快照，不能修改历史来源记录。
4. 每次新批次单独归档日志和输入身份，不覆盖本目录；完成后合并原始身份、检查无重复/遗漏，
   三组最终各 145 项才认定完整通过。
5. 汇总器当前要求一个完整 145 例日志；恢复时扩展为验证多个批次，再统计全部真实结果，
   不人工拼接或伪造一个仿真 PASS。

完整协议见 [512 测量协议](../../../../docs/MLKEM512_BENCHMARK_PROTOCOL.md)。
