hongpengWu/mlkem-polymul-rv32i-fpga/docs/VALIDATION.md

# 验证记录

更新时间：2026-10-23。本文区分RTL仿真、实现签核与实板数据。
K4加速overlay实板145/145证据在 `results/keccak_cpu/board/20261016_full145/`；
独立PL签核历史证据在 `results/keccak_cpu/board/20261004_162430/`。

## 当前结果

| 项目 | 状态 | 证据 |
|---|---|---|
| K4 PS–PL CPU+Keccak 全量实板 | `FULL_PASS`，145条唯一覆盖；官方输出/返回值、身份、哈希及3,188次硬件启动独立复核通过 | [原始JSON与复核入口](../results/keccak_cpu/board/20261016_full145/README.md) |
| K4 CPU-only / CPU+Keccak同板配对 | 两组各145/145；独立核验官方输出、输入、哈希、计数；API 3.802806×，PS整批2.297581× | [2026-10-23实板配对](../results/k4/paired_firmware/board_20261023/summary.md) |
| K4代表例重复与控制恢复实板 | 两组0/1/115各10次共60次通过，6项控制恢复通过；8次固件全RAM读回哈希一致 | [独立复核](../results/k4/paired_firmware/board_20261023/verification.json) |
| K4配对固件RTL切换 | 7/7官方子集、三次全RAM回读通过 | [RTL原始证据](../results/k4/paired_firmware/rtl_01/result.json) |
| K4历史完整系统OOC布局布线 | 两组均完成且资源足够；CPU-only内部时序通过，加速组setup −1.367 ns，尚未收敛100 MHz | [完整系统实现报告](../results/keccak_cpu/system_impl/20260927_194022/summary.md) |
| K4历史CPU＋Keccak官方RTL KAT | PASS，19批145/145唯一覆盖，3,188次真实HLS调用、68次续取；同配置API总周期比3.803× | [全量证据](../results/keccak_cpu/kat/summary.md) |
| K4当前timing_decode_v3组件/译码 | 10次硬件调用、216字及262,144个高位区域/16,384个窗口字节等价检查PASS | [当前smoke](../results/keccak_cpu/smoke/20261004_121658_132844/)、[实现记录](MLKEM1024_SYSTEM_IMPLEMENTATION.md) |
| K4当前timing_decode_v3官方全量RTL | 最终145/145，19批唯一覆盖、最终PASS与冻结输入哈希通过；3,188次真实硬件启动 | [当前全量证据](../results/keccak_cpu/candidates/timing_decode_v3/kat/summary.md) |
| K4当前timing_decode_v3系统OOC | 100 MHz内部setup/hold +0.269/+0.029 ns；资源足够、routed DCP已保存；边界hold −1.194 ns，整体timing_met=false | [恢复实现结果](../results/keccak_cpu/system_impl/20261004_124354/keccak/result.json) |
| K4 PYNQ-Z2 板级上板前签核 | PASS，真实125→100 MHz MMCM、BTN0忙时复位和官方子集3/3；setup/hold/pulse +0.109/+0.027/+2.000 ns；路由28,091/28,091；功能风险DRC 0 | [最终证据](../results/keccak_cpu/board/20261004_162430/result.json) |
| CPU-only 多项式 baseline | PASS，RV32I/RV32IM-iterative/RV32IM-fast 各 8 组、4096 项检查 | [`results/cpu_baseline/`](../results/cpu_baseline/) |
| ML-KEM-512 官方 PicoRV32 回归 | PASS，三种 CPU 各 145/145 | [`results/official_baseline/mlkem512/`](../results/official_baseline/mlkem512/) |
| ML-KEM-768 官方 PicoRV32 回归 | PASS，RV32IM-fast 145/145，128 KiB RAM/32 KiB栈 | [768汇总](../results/official_baseline/mlkem768/rv32im_fast/summary.md) |
| ML-KEM-1024 官方 PicoRV32 回归 | PASS，RV32IM-fast 145/145，128 KiB RAM/32 KiB栈 | [1024汇总](../results/official_baseline/mlkem1024/rv32im_fast/summary.md) |
| 主机端 FIPS 203/ACVP | PASS，512/768/1024 合计 435 条 | [`results/official_reference/`](../results/official_reference/) |
| KeyGen 官方 tcId=1 | PASS，三种 CPU | [`results/official_baseline/keygen512_tc1/`](../results/official_baseline/keygen512_tc1/) |
| RV32IM 指令配置 | PASS，迭代和快速乘法配置均在软件回归中使用 | [`tb/cpu/`](../tb/cpu/) |
| 新 HLS C 仿真 | PASS，103/103 | [`results/accelerator_interface/basemul_k2_csim.txt`](../results/accelerator_interface/basemul_k2_csim.txt) |
| 新 HLS 2024.2 综合 | PASS，II=1，估算 137 cycles、150.83 MHz | [`results/accelerator_interface/hls_synthesis/`](../results/accelerator_interface/hls_synthesis/) |
| 新 HLS MMIO/BRAM Vivado 顶层 | PASS，3 组 × 256 个系数逐项通过；协议检查覆盖字节使能、busy 保护、非法访问、重复启动和复位中止 | [`results/accelerator_interface/rtl_sim/simulate.log`](../results/accelerator_interface/rtl_sim/simulate.log) |
| PYNQ-Z2 BIST 顶层 RTL | PASS，两次完整运行、256 个结果字检查和一次故障注入；时钟/按钮复位测试通过 | [`results/accelerator_interface/rtl_sim/board_simulate.log`](../results/accelerator_interface/rtl_sim/board_simulate.log) |
| Vivado 2024.2 独立实现 | PASS，WNS=0.732 ns、WHS=0.129 ns、BRAM=8、DSP=12 @ 100 MHz | [`results/accelerator_interface/vivado_impl/`](../results/accelerator_interface/vivado_impl/) |
| CPU+PQC 局部接口 | PASS，RV32IM-fast 执行 C 驱动，3 组、768 个系数 | [接口验证](MLKEM512_CPU_ACCEL_SMOKE.md) |
| CPU+PQC 官方 KAT | PASS，145/145 ML-KEM-512 | [`results/accelerator_cpu/kat/`](../results/accelerator_cpu/kat/)；端到端 0.9930×，当前为功能闭环而非性能收益 |
| K4 独立PL自检烧录 | 用户报告LED0 PASS及BTN0复位恢复；与PS–PL全量实测分别记录 | [独立PL签核](../results/keccak_cpu/board/20261004_162430/result.json) |

开发使用`mainline/k4/flow.tcl`与`mainline/k4/bd_axi.tcl`顶部开关，默认官方索引0、1、115子集；145条只在最终候选稳定后验收。
每个RTL版本独立归档并检查输入哈希。历史145/145和3.803×不自动计入当前版本，子集不代表全量通过。

## 官方数据口径

主机端的 435 条记录覆盖 ML-KEM-512/768/1024；PicoRV32已完成
ML-KEM-512三种CPU各145条，及ML-KEM-768/1024 RV32IM-fast各145条。CPU+PQC 加速版同样完成 145/145 条 ML-KEM-512 记录，
并核验了每条记录的 MMIO 调用计数、核心周期和输出。K4历史CPU＋Keccak版本也已完成145/145，
输入/输出分别核对287,360/199,360 B，覆盖密钥生成、封装、解封装、从种子重建及密钥检查；
HASH/SQUEEZE、缓冲事务数、实际启动/完成、栈与两次rdcycle边界逐条验证。PicoRV32 的通过结果证明固定软件、
输入、输出和 RTL 执行路径一致，不代表正式 CAVP 认证，也不代表实体板结果。

## HLS 证据边界

以下K=2历史HLS只验证标准库NTT域cached BaseMul。K=4独立Keccak的109笔差分、
CPU组件10项与完整KEM官方145项属于三个不同验证层次，分别保存证据。

K=2 HLS：C 仿真、HLS 综合和独立 native
MMIO/BRAM RTL 已通过，但仍不验证 PicoRV32 总线接入、完整 NTT/INTT 或端到端 KEM。
HLS 报告的 137 cycles 与 adapter RTL 实测核心 136 cycles 都只属于核心边界，不能直接
换算系统加速比。

本轮修正了 C testbench 的 zeta 表漏项（`-1103, 430`），并重跑 103 个用例。历史
`hls_synthesis/summary.json` 保留当时综合和 C 仿真的源码哈希；计算核源码没有改动，
当前 C 验证使用修正后的 TB，证据为 `basemul_k2_csim.txt`。综合报告中的历史 TB 哈希
不应当作本轮 C 回归的哈希。
本轮源码、TB、XPR、日志、报告与 bitstream 的 SHA-256 见
[`delivery_manifest.json`](../results/accelerator_interface/delivery_manifest.json)。

## 可重复性要求

所有新测量都应保存：工具版本、参数集、CPU 配置、输入/输出哈希、核心周期、搬运周期、
CPU API 周期、资源、时序和实现日志。新结果写入 [`docs/BENCHMARKS.md`](BENCHMARKS.md)
和 [`docs/PROJECT_STATUS.md`](PROJECT_STATUS.md)，不要覆盖已有官方证据。
