hongpengWu/mlkem-polymul-rv32i-fpga/results/official_baseline/keygen512_tc1/summary.md

# PicoRV32：官方 ML-KEM-512 KeyGen 单用例

ACVP FIPS203 / tgId=1 / tcId=1。Vivado 2024.2 RTL 仿真；每组一个样本。

| CPU 配置 | KeyGen 周期 | 时间 @100 MHz (ms) | 相对 RV32I | 输入/输出核对 (B) | 动态 MUL |
|---|---:|---:|---:|---:|---:|
| rv32i | 8,995,082 | 89.95082 | 1.0000× | 64 / 2432 PASS | 0 |
| rv32im_iterative | 5,812,531 | 58.12531 | 1.5475× | 64 / 2432 PASS | 18,176 |
| rv32im_fast | 5,194,547 | 51.94547 | 1.7316× | 64 / 2432 PASS | 18,176 |

计时仅覆盖 `keypair_derand()` 调用，种子已就绪；包含库内默认清零，不含输入/输出调试传输、启动、结果检查及熵源采集。空计时区间 4 周期单列、不扣除。

| CPU 配置 | 镜像有效字节 | 静态区结束地址（十进制） | RAM (B) | 栈预留 / 观测使用 (B) |
|---|---:|---:|---:|---:|
| rv32i | 19,424 | 21,920 | 65,536 | 16,384 / 9,328 |
| rv32im_iterative | 18,848 | 21,344 | 65,536 | 16,384 / 9,328 |
| rv32im_fast | 18,848 | 21,344 | 65,536 | 16,384 / 9,328 |

栈使用按本用例观测到的最低 SP 计算；不是所有合法输入的最坏情况上界。当前工程未做综合/布局布线，100 MHz 时间为仿真周期换算。未覆盖完整 KEM、全部 KAT 或实板，也不代表 NIST 认证。

来源、镜像、日志和当前构建输入 SHA-256 见 `summary.json` 与 `build_manifest.json`。
