hongpengWu/mlkem-polymul-rv32i-fpga/results/official_baseline/mlkem512/summary.md

# PicoRV32 ML-KEM-512 官方公开向量回归

三组 CPU 各合并验证 145 条固定版本 ACVP 记录；输入核对 148,160 B、输出核对 101,760 B／组。
Vivado 2024.2 RTL 仿真，100 MHz 时间仅为周期换算。未做实板测量或正式认证。

每条记录执行一次。P95 使用 nearest-rank；不同数据集可能包含相同输入，样本数表示记录数。KeyCheck 成功／失败分别统计；seed decapsulation 包含 KeyGen 展开，不与 expanded decapsulation 混合。

本次结果由关机前已验证的 25／31／38 条记录与独立完成的续跑批次合并。原始 case_index 完整且唯一；旧日志没有最终 PASS，未拼造单次全套 PASS。全程周期与 M 总数无法从原始未完成前缀恢复，summary.json 中对应字段为 null。下表“续跑批次全程 M”仅包含续跑批次（包括每批启动）；“全部算法区间 M”覆盖全部 145 条。栈列为原始算法区间及完整续跑批次中的最大观测深度。

| CPU | 固件有效 B | 静态区结束地址 | RAM B | 栈预留 / 已有观测最大 B | 续跑批次全程 M / 全部算法区间 M |
|---|---:|---:|---:|---:|---:|
| rv32i | 27,808 | 33,476 | 65,536 | 16,384 / 12,928 | 0 / 0 |
| rv32im_iterative | 26,272 | 31,940 | 65,536 | 16,384 / 12,928 | 2,912,384 / 3,486,720 |
| rv32im_fast | 26,272 | 31,940 | 65,536 | 16,384 / 12,928 | 2,712,192 / 3,486,720 |

## 按操作汇总

| CPU | 数据集 | 操作 / 返回值 | N | 最小周期 | 平均周期 | 中位周期 | P95 周期 | 最大周期 | 平均 ms | 对 RV32I | 输入 / 输出 B | M 指令总计 | 算法栈最大 B |
|---|---|---|---:|---:|---:|---:|---:|---:|---:|---:|---:|---:|---:|
| rv32i | 全部 | keyGen / 0 | 25 | 8,957,350 | 9,063,343.76 | 8,989,423.0 | 9,620,491 | 9,622,095 | 90.63344 | 1.000× | 1,600 / 60,800 | 0 | 9,424 |
| rv32i | 全部 | encapsulation / 0 | 50 | 11,706,746 | 11,798,692.24 | 11,751,853.0 | 12,377,000 | 12,392,025 | 117.98692 | 1.000× | 41,600 / 40,000 | 0 | 12,112 |
| rv32i | 全部 | decapsulation / 0 | 20 | 15,697,334 | 15,740,996.15 | 15,735,310.0 | 15,780,222 | 15,790,450 | 157.40996 | 1.000× | 48,000 / 640 | 0 | 12,928 |
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
| rv32im_fast | 2 | decapsulationKeyCheck / 0 | 5 | 941,441 | 941,441.00 | 941,441.0 | 941,441 | 941,441 | 9.41441 | 1.000× | 8,160 / 0 | 0 | 896 |
| rv32im_fast | 3 | encapsulation / 0 | 25 | 5,529,867 | 5,556,302.24 | 5,531,332.0 | 5,532,240 | 6,157,711 | 55.56302 | 2.120× | 20,800 / 20,000 | 758,400 | 12,112 |
| rv32im_fast | 3 | decapsulation / 0 | 10 | 6,936,218 | 6,937,812.40 | 6,937,686.0 | 6,939,387 | 6,939,387 | 69.37812 | 2.269× | 24,000 / 320 | 437,760 | 12,928 |
| rv32im_fast | 3 | decapsulationKeyCheck / 0 | 5 | 941,441 | 941,441.00 | 941,441.0 | 941,441 | 941,441 | 9.41441 | 1.000× | 8,160 / 0 | 0 | 896 |
| rv32im_fast | 3 | decapsulationKeyCheck / -5 | 5 | 941,452 | 941,452.00 | 941,452.0 | 941,452 | 941,452 | 9.41452 | 1.000× | 8,160 / 0 | 0 | 896 |
| rv32im_fast | 3 | encapsulationKeyCheck / -4 | 5 | 128,943 | 128,943.00 | 128,943.0 | 128,943 | 128,943 | 1.28943 | 1.194× | 4,000 / 0 | 5,120 | 2,016 |
| rv32im_fast | 3 | encapsulationKeyCheck / 0 | 5 | 128,932 | 128,932.00 | 128,932.0 | 128,932 | 128,932 | 1.28932 | 1.194× | 4,000 / 0 | 5,120 | 2,016 |

数据集 1：FIPS203 KeyGen；2：FIPS203 encapDecap；3：FIPS203-tr1 encapDecap。

计时排除 mailbox 输入／输出、启动、预期值检查和熵源采集；包括库内清零。空计时区间原值保留、不扣除。栈使用是本次回归观测值，不是所有输入的最坏情况上界。

逐例数据见 `cases.csv`；来源、固件、仿真输入与日志 SHA-256 见 `summary.json`、`build_manifest.json` 、`checkpoint/` 与各 `batches/<config>/<batch>/run_inputs.json`。
