hongpengWu/mlkem-polymul-rv32i-fpga/results/official_baseline/mlkem768/rv32im_fast/summary.md

# ML-KEM-768 rv32im_fast 官方公开向量回归

145/145 条官方记录逐字节验证通过，包含两类 KeyCheck 的有效／无效返回。
CPU-only Vivado/XSim 2024.2 RTL 仿真；128 KiB RAM、32 KiB 栈。100 MHz 时间仅为周期换算。

算法总周期：1,112,525,793；输入／输出核对：215,360 / 146,560 B；全程观测栈：18,432 B。

| 操作 | 返回值 | N | 最小周期 | 平均周期 | 中位周期 | P95 周期 | 最大周期 |
|---|---:|---:|---:|---:|---:|---:|---:|
| keyGen | 0 | 25 | 8,294,718 | 8,322,064.56 | 8,297,188.0 | 8,299,377 | 8,923,167 |
| encapsulation | 0 | 50 | 9,042,398 | 9,121,014.10 | 9,046,127.5 | 9,672,512 | 10,296,301 |
| decapsulation | 0 | 20 | 11,015,828 | 11,081,487.00 | 11,018,960.5 | 11,644,158 | 11,647,045 |
| decapsulationSeed | 0 | 10 | 19,312,135 | 19,472,435.40 | 19,316,296.0 | 20,570,785 | 20,570,785 |
| encapsulationKeyCheck | 0 | 10 | 193,076 | 193,076.00 | 193,076.0 | 193,076 | 193,076 |
| decapsulationKeyCheck | 0 | 10 | 1,410,382 | 1,410,382.00 | 1,410,382.0 | 1,410,382 | 1,410,382 |
| encapsulationKeyCheck | -4 | 10 | 193,087 | 193,087.00 | 193,087.0 | 193,087 | 193,087 |
| decapsulationKeyCheck | -5 | 10 | 1,410,393 | 1,410,393.00 | 1,410,393.0 | 1,410,393 | 1,410,393 |

计时包括 API 内部计算与清零，seed 解封装包括密钥展开；不含 mailbox、oracle 核对、启动和熵源采集。空计时区间保留、不扣除。

每条官方记录执行一次，P95 为 nearest-rank；不是正式认证或实板结果，也不代表 K=3/K=4 加速硬件已通过。栈为观测值，非最坏情况上界。

与 ML-KEM-512 的 64 KiB RAM／16 KiB 栈口径不同。逐例数据见 cases.csv，日志及冻结输入证据见 summary.json 和各 run_inputs.json。
