hongpengWu/mlkem-polymul-rv32i-fpga/results/cpu_baseline/cpu_benchmark_rows.csv

config | case | mode | cpu_mul | cpu_fast_mul | cpu_div | expect_m | prepare | ntt_a | ntt_b | basemul | invntt | canonical | total | empty | m_total | mul | mulh | mulhsu | mulhu | div | divu | rem | remu | min_sp | checksum
rv32i | 0 | unsegmented | 0 | 0 | 0 | 0 | -1 | -1 | -1 | -1 | -1 | -1 | 2829659 | 4 | 0 | 0 | 0 | 0 | 0 | 0 | 0 | 0 | 0 | 0x00003f20 | 0x811c9dc5
rv32i | 0 | profiled | 0 | 0 | 0 | 0 | 6543 | 763907 | 763911 | 402941 | 855464 | 36896 | 2829662 | 4 | 0 | 0 | 0 | 0 | 0 | 0 | 0 | 0 | 0 | 0x00003f20 | 0x811c9dc5
rv32i | 1 | unsegmented | 0 | 0 | 0 | 0 | -1 | -1 | -1 | -1 | -1 | -1 | 2818256 | 4 | 0 | 0 | 0 | 0 | 0 | 0 | 0 | 0 | 0 | 0x00003f20 | 0x3b73945a
rv32i | 1 | profiled | 0 | 0 | 0 | 0 | 6543 | 763907 | 763911 | 391538 | 855464 | 36896 | 2818259 | 4 | 0 | 0 | 0 | 0 | 0 | 0 | 0 | 0 | 0 | 0x00003f20 | 0x3b73945a
rv32i | 2 | unsegmented | 0 | 0 | 0 | 0 | -1 | -1 | -1 | -1 | -1 | -1 | 2604377 | 4 | 0 | 0 | 0 | 0 | 0 | 0 | 0 | 0 | 0 | 0x00003f20 | 0x811c9dad
rv32i | 2 | profiled | 0 | 0 | 0 | 0 | 6543 | 763907 | 763911 | 177659 | 855464 | 36896 | 2604380 | 4 | 0 | 0 | 0 | 0 | 0 | 0 | 0 | 0 | 0 | 0x00003f20 | 0x811c9dad
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
