hongpengWu/mlkem-polymul-rv32i-fpga/results/k4/candidates/structure_check/kat/cases.csv

index | dataset | vsId | tgId | tcId | op | return_code | raw_cycles | empty_cycles | input_bytes | output_bytes | m_total | mul | mulh | mulhsu | mulhu | div | divu | rem | remu | min_sp | case_index | operation | expected_implicit_rejection | starts | done | hash | squeeze | busy | buffer_writes | buffer_reads | software_cycles | accelerated_cycles | speedup | busy_ratio | other_api_cycles | attempt
0 | 1 | 42 | 3 | 51 | 1 | 0 | 3120949 | 4 | 64 | 4736 | 40452 | 40452 | 0 | 0 | 0 | 0 | 0 | 0 | 0 | 111984 | 0 | keyGen |  | 26 | 26 | 26 | 0 | 16293 | 1969 | 3648 | 13046698 | 3120949 | 4.180362447447876 | 0.005220527474175323 | 3104656 | E:\pqc\mlkem-polymul-rv32i-fpga\results\k4\candidates\structure_check\kat\batches\pilot_000_001_115\20261014_154423_955528
1 | 2 | 42 | 3 | 51 | 2 | 0 | 3841529 | 4 | 1600 | 1600 | 58244 | 57220 | 0 | 0 | 1024 | 0 | 0 | 0 | 0 | 108288 | 1 | encapsulation |  | 27 | 27 | 27 | 0 | 16580 | 2037 | 3732 | 13908293 | 3841529 | 3.620509698091567 | 0.0043159898051010415 | 3824949 | E:\pqc\mlkem-polymul-rv32i-fpga\results\k4\candidates\structure_check\kat\batches\pilot_000_001_115\20261014_154423_955528
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
