hongpengWu/mlkem-polymul-rv32i-fpga/results/keccak_cpu/call_profile/calls.csv

case_index | operation | stage | event_index | algorithm | phase | lanes | input_bytes_per_lane | output_bytes_per_lane | stream_id | squeeze_index | scalar_permutations | x4_permute_calls
0 | keyGen | keyGen | 0 | SHA3-512 | oneshot | 1 | 33 | 64 | -1 | -1 | 1 | 0
0 | keyGen | keyGen | 1 | SHAKE128 | absorb | 4 | 34 | 0 | 0 | -1 | 0 | 0
0 | keyGen | keyGen | 2 | SHAKE128 | squeeze | 4 | 0 | 504 | 0 | 0 | 12 | 3
0 | keyGen | keyGen | 3 | SHAKE128 | absorb | 4 | 34 | 0 | 1 | -1 | 0 | 0
0 | keyGen | keyGen | 4 | SHAKE128 | squeeze | 4 | 0 | 504 | 1 | 0 | 12 | 3
0 | keyGen | keyGen | 5 | SHAKE128 | absorb | 4 | 34 | 0 | 2 | -1 | 0 | 0
0 | keyGen | keyGen | 6 | SHAKE128 | squeeze | 4 | 0 | 504 | 2 | 0 | 12 | 3
0 | keyGen | keyGen | 7 | SHAKE128 | absorb | 4 | 34 | 0 | 3 | -1 | 0 | 0
0 | keyGen | keyGen | 8 | SHAKE128 | squeeze | 4 | 0 | 504 | 3 | 0 | 12 | 3
0 | keyGen | keyGen | 9 | SHAKE256 | oneshot | 1 | 33 | 128 | -1 | -1 | 1 | 0
0 | keyGen | keyGen | 10 | SHAKE256 | oneshot | 1 | 33 | 128 | -1 | -1 | 1 | 0
0 | keyGen | keyGen | 11 | SHAKE256 | oneshot | 1 | 33 | 128 | -1 | -1 | 1 | 0
0 | keyGen | keyGen | 12 | SHAKE256 | oneshot | 1 | 33 | 128 | -1 | -1 | 1 | 0
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
