hongpengWu/mlkem-polymul-rv32i-fpga/results/official_baseline/mlkem1024/rv32im_fast/summary.md

# ML-KEM-1024 rv32im_fast 官方公开向量回归

145/145 条官方记录逐字节验证通过，包含两类 KeyCheck 的有效／无效返回。
CPU-only Vivado/XSim 2024.2 RTL 仿真；128 KiB RAM、32 KiB 栈。100 MHz 时间仅为周期换算。

算法总周期：1,699,294,360；输入／输出核对：287,360 / 199,360 B；全程观测栈：24,464 B。

| 操作 | 返回值 | N | 最小周期 | 平均周期 | 中位周期 | P95 周期 | 最大周期 |
|---|---:|---:|---:|---:|---:|---:|---:|
| keyGen | 0 | 25 | 13,043,366 | 13,172,005.28 | 13,046,869.0 | 13,675,932 | 13,676,283 |
| encapsulation | 0 | 50 | 13,905,404 | 14,009,378.52 | 13,909,627.5 | 14,535,408 | 15,161,690 |
| decapsulation | 0 | 20 | 16,456,501 | 16,586,545.60 | 16,462,040.5 | 17,088,709 | 17,088,752 |
| decapsulationSeed | 0 | 10 | 29,503,364 | 29,505,999.00 | 29,504,975.0 | 29,511,242 | 29,511,242 |
| encapsulationKeyCheck | 0 | 10 | 257,406 | 257,406.00 | 257,406.0 | 257,406 | 257,406 |
| decapsulationKeyCheck | -5 | 10 | 1,879,314 | 1,879,314.00 | 1,879,314.0 | 1,879,314 | 1,879,314 |
| encapsulationKeyCheck | -4 | 10 | 257,417 | 257,417.00 | 257,417.0 | 257,417 | 257,417 |
| decapsulationKeyCheck | 0 | 10 | 1,879,303 | 1,879,303.00 | 1,879,303.0 | 1,879,303 | 1,879,303 |

计时包括 API 内部计算与清零，seed 解封装包括密钥展开；不含 mailbox、oracle 核对、启动和熵源采集。空计时区间保留、不扣除。

每条官方记录执行一次，P95 为 nearest-rank；不是正式认证或实板结果，也不代表 K=3/K=4 加速硬件已通过。栈为观测值，非最坏情况上界。

与 ML-KEM-512 的 64 KiB RAM／16 KiB 栈口径不同。逐例数据见 cases.csv，日志及冻结输入证据见 summary.json 和各 run_inputs.json。
