hongpengWu/mlkem-polymul-rv32i-fpga/results/accelerator_cpu/kat/cases.csv

case_index | dataset | vsId | tgId | tcId | op | operation | return_code | software_cycles | hardware_cycles | empty_cycles | input_bytes | output_bytes | m_total | mul | mulh | mulhsu | mulhu | div | divu | rem | remu | min_sp | starts | done | loads | reads | core_cycles | load_cycles | read_cycles | remaining_api_cycles | load_ratio | core_ratio | read_ratio | remaining_api_ratio | speedup | speedup_per_sample
0 | 1 | 42 | 1 | 1 | 1 | keyGen | 0 | 5194599 | 5223313 | 4 | 64 | 2432 | 15104 | 15104 | 0 | 0 | 0 | 0 | 0 | 0 | 0 |  | 2 | 2 | 1280 | 256 | 272 | 84734 | 11686 | 5126621 | 0.016222271190717463 | 5.2074229516783695e-05 | 0.0022372773754894644 | 0.9814883772042763 | 0.9945027226972613 | 0.9945027226972613
1 | 2 | 42 | 1 | 1 | 2 | encapsulation | 0 | 5530291 | 5573362 | 4 | 832 | 800 | 25728 | 25216 | 0 | 0 | 512 | 0 | 0 | 0 | 0 |  | 3 | 3 | 1920 | 384 | 408 | 127101 | 17529 | 5428324 | 0.02280508605039472 | 7.320536509202165e-05 | 0.003145139325240313 | 0.9739765692592729 | 0.9922719895101018 | 0.9922719895101018
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
