hongpengWu/mlkem-polymul-rv32i-fpga/results/k4/paired_firmware/rtl_01/snapshot/rtl/mlkem1024_keccak_system.sv

`timescale 1ns/1ps
// Separate integration target: the CPU-only baseline remains unchanged.
// One outstanding transaction, independent AXI AW/W capture, buffered R/B.
module mlkem1024_keccak_system #(
    parameter FIRMWARE_INIT_FILE = "mlkem1024_keccak.mem",
    parameter integer RAM_ADDR_BITS = 15,
    parameter CPU_ENABLE_MUL = 1,
    parameter CPU_ENABLE_FAST_MUL = 1,
    parameter CPU_ENABLE_DIV = 1,
    parameter ENABLE_HOST = 0
)(
    input wire clk, resetn,
    output wire trap,
    output wire [31:0] status_out,
    output wire [383:0] profile_words,
    input wire host_en,
    input wire [3:0] host_we,
    input wire [RAM_ADDR_BITS-1:0] host_addr,
    input wire [31:0] host_din,
    output wire [31:0] host_dout,
    output wire [31:0] hls_starts, hls_busy_cycles,
    output wire [31:0] buffer_writes, buffer_reads
);
    localparam [31:0] RAM_LIMIT = (1 << (RAM_ADDR_BITS+2));
    localparam [31:0] DBG_BASE = 32'h50000000;
    localparam [31:0] ACC_BASE = 32'h50010000;
    // The direct RAM write path requires RAM and MMIO address spaces to be
    // disjoint. Larger configurations would overlap DBG_BASE/ACC_BASE.
    initial begin
        if (RAM_ADDR_BITS < 1 || RAM_ADDR_BITS > 28)
            $fatal(1, "RAM_ADDR_BITS must be in 1..28; RAM must not overlap MMIO");
    end
    reg [31:0] debug_regs[0:15];
    integer i, byte_i;
    initial for(i=0;i<16;i=i+1) debug_regs[i]=0;
    assign status_out=debug_regs[0];
    genvar p;
    generate for(p=0;p<12;p=p+1) begin: profile_export
        assign profile_words[32*p+:32]=debug_regs[p];
    end endgenerate

    wire c_awvalid,c_awready,c_wvalid,c_wready,c_bvalid,c_bready;
    wire c_arvalid,c_arready,c_rvalid,c_rready;
    wire [31:0] c_awaddr,c_wdata,c_araddr,c_rdata;
    wire [3:0] c_wstrb;
    picorv32_axi #(
        .ENABLE_COUNTERS(1),.ENABLE_COUNTERS64(0),
        .ENABLE_MUL(CPU_ENABLE_MUL),.ENABLE_FAST_MUL(CPU_ENABLE_FAST_MUL),
        .ENABLE_DIV(CPU_ENABLE_DIV),.ENABLE_TRACE(1),.REGS_INIT_ZERO(1),
        .STACKADDR(RAM_LIMIT-16)
    ) cpu (
        .clk(clk),.resetn(resetn),.trap(trap),
        .mem_axi_awvalid(c_awvalid),.mem_axi_awready(c_awready),.mem_axi_awaddr(c_awaddr),.mem_axi_awprot(),
        .mem_axi_wvalid(c_wvalid),.mem_axi_wready(c_wready),.mem_axi_wdata(c_wdata),.mem_axi_wstrb(c_wstrb),
        .mem_axi_bvalid(c_bvalid),.mem_axi_bready(c_bready),
        .mem_axi_arvalid(c_arvalid),.mem_axi_arready(c_arready),.mem_axi_araddr(c_araddr),.mem_axi_arprot(),
        .mem_axi_rvalid(c_rvalid),.mem_axi_rready(c_rready),.mem_axi_rdata(c_rdata),
        .pcpi_wr(1'b0),.pcpi_rd(32'b0),.pcpi_wait(1'b0),.pcpi_ready(1'b0),
        .irq(32'b0),.eoi(),.trace_valid(),.trace_data()
    );
    // RAM_ADDR_BITS=15 maps 128 KiB at 0x00000000.  Testing the upper
    // address bits avoids a wide comparator on the CPU ready/address path.
    wire write_sel_ram=!c_awaddr[31:RAM_ADDR_BITS+2];
    wire read_sel_ram=!c_araddr[31:RAM_ADDR_BITS+2];
    wire write_sel_dbg=c_awaddr[31:6]==DBG_BASE[31:6];
    wire read_sel_dbg=c_araddr[31:6]==DBG_BASE[31:6];
    // The 16 KiB accelerator window is aligned to bit 14.
    wire write_sel_acc=c_awaddr[31:14]==ACC_BASE[31:14];
    wire read_sel_acc=c_araddr[31:14]==ACC_BASE[31:14];
    reg local_aw_hold,local_w_hold,local_bvalid,local_rvalid,local_read_is_ram;
    reg accel_read_pending;
    reg [31:0] local_awaddr,local_wdata,local_rdata;
    reg [3:0] local_wstrb;
    wire [31:0] boot_rdata;
    // W must not depend on AWVALID/AWADDR: either channel can arrive first.
    wire local_awready=resetn && !local_aw_hold && !local_bvalid &&
                       !local_rvalid && !accel_read_pending;
    wire local_wready=resetn && !local_w_hold && !local_bvalid &&
                      !local_rvalid && !accel_read_pending;
    wire local_aw_fire=c_awvalid && c_awready;
    wire local_w_fire=c_wvalid && c_wready;
    wire write_pending=!local_bvalid &&
        (local_aw_hold || local_aw_fire) && (local_w_hold || local_w_fire);
    wire [31:0] commit_addr=local_aw_hold ? local_awaddr : c_awaddr;
    wire [31:0] commit_data=local_w_hold ? local_wdata : c_wdata;
    wire [3:0] commit_strb=local_w_hold ? local_wstrb : c_wstrb;
    wire commit_is_acc=commit_addr[31:14]==ACC_BASE[31:14];
    wire commit_is_ram=!commit_addr[31:RAM_ADDR_BITS+2];
    wire accel_bus_ready,accel_bus_rvalid;
    wire [31:0] accel_bus_rdata;
    wire local_write_commit=write_pending && (!commit_is_acc || accel_bus_ready);
    // Serialize reads against writes because the firmware RAM has one port.
    // No later access can change its output while an AXI R response is held.
    wire local_arready=resetn && !local_rvalid && !accel_read_pending &&
        !local_aw_hold && !local_w_hold && !local_bvalid &&
        !c_awvalid && !c_wvalid;
    wire accel_write_request=write_pending && commit_is_acc;
    wire accel_read_request=c_arvalid && local_arready && read_sel_acc;
    wire local_ar_fire=c_arvalid && c_arready;
    assign c_awready=(write_sel_ram || write_sel_dbg || write_sel_acc) && local_awready;
    assign c_wready=local_wready;
    assign c_bvalid=local_bvalid;
    assign c_arready=(read_sel_ram || read_sel_dbg || read_sel_acc) &&
        local_arready && (!read_sel_acc || accel_bus_ready);
    assign c_rvalid=local_rvalid;
    assign c_rdata=local_read_is_ram ? boot_rdata : local_rdata;

    keccak_mmio_adapter #(.BASE_ADDR(ACC_BASE)) adapter_i (
        .clk(clk),.resetn(resetn),
        .bus_valid(accel_write_request || accel_read_request),
        .bus_write(accel_write_request),
        .bus_addr(accel_write_request ? commit_addr : c_araddr),
        .bus_wdata(commit_data),.bus_wstrb(commit_strb),
        .bus_ready(accel_bus_ready),.bus_rvalid(accel_bus_rvalid),.bus_rdata(accel_bus_rdata),
        .accel_busy(),.accel_done(),.accel_error(),.transaction_count(hls_starts),
        .hls_cycles(hls_busy_cycles),.buffer_writes(buffer_writes),.buffer_reads(buffer_reads)
    );

    // RAM writes are disjoint from the accelerator window, so they must not
    // wait on accelerator ready.  This removes the ready feedback from the
    // RAM address select while preserving the AXI write response behavior.
    wire boot_write=write_pending && commit_is_ram;
    wire boot_read=local_ar_fire && read_sel_ram;
    wire [RAM_ADDR_BITS-1:0] boot_addr=boot_write ? commit_addr[RAM_ADDR_BITS+1:2] : c_araddr[RAM_ADDR_BITS+1:2];
    // The optional host port does not change the CPU's one-cycle RAM latency.
    // The enclosing AXI slave enforces ownership; reset never clears RAM.
    generate if (ENABLE_HOST) begin: host_memory
    xpm_memory_tdpram #(
        .ADDR_WIDTH_A(RAM_ADDR_BITS),.ADDR_WIDTH_B(RAM_ADDR_BITS),.AUTO_SLEEP_TIME(0),
        .BYTE_WRITE_WIDTH_A(8),.BYTE_WRITE_WIDTH_B(8),.CASCADE_HEIGHT(0),
        .CLOCKING_MODE("common_clock"),.ECC_MODE("no_ecc"),.MEMORY_INIT_FILE(FIRMWARE_INIT_FILE),
        .MEMORY_INIT_PARAM("0"),.MEMORY_OPTIMIZATION("true"),.MEMORY_PRIMITIVE("block"),
        .MEMORY_SIZE(32*(1<<RAM_ADDR_BITS)),.MESSAGE_CONTROL(0),
        .READ_DATA_WIDTH_A(32),.READ_DATA_WIDTH_B(32),.READ_LATENCY_A(1),.READ_LATENCY_B(1),
        .READ_RESET_VALUE_A("0"),.READ_RESET_VALUE_B("0"),.RST_MODE_A("SYNC"),.RST_MODE_B("SYNC"),
        .SIM_ASSERT_CHK(0),.USE_MEM_INIT(1),.WAKEUP_TIME("disable_sleep"),
        .WRITE_DATA_WIDTH_A(32),.WRITE_DATA_WIDTH_B(32),
        .WRITE_MODE_A("read_first"),.WRITE_MODE_B("read_first")
    ) firmware_bram (
        .clka(clk),.clkb(clk),.ena(boot_write || boot_read),.addra(boot_addr),.dina(commit_data),
        .wea(boot_write ? commit_strb : 4'b0000),.douta(boot_rdata),
        .enb(host_en),.addrb(host_addr),.dinb(host_din),.web(host_we),.doutb(host_dout),
        .rsta(1'b0),.rstb(1'b0),.regcea(1'b1),.regceb(1'b1),.sleep(1'b0),
        .injectsbiterra(1'b0),.injectdbiterra(1'b0),.injectsbiterrb(1'b0),.injectdbiterrb(1'b0),
        .sbiterra(),.dbiterra(),.sbiterrb(),.dbiterrb()
    );
    end else begin: standalone_memory
    assign host_dout=32'b0;
    xpm_memory_spram #(
        .ADDR_WIDTH_A(RAM_ADDR_BITS),.AUTO_SLEEP_TIME(0),.BYTE_WRITE_WIDTH_A(8),
        .CASCADE_HEIGHT(0),.ECC_MODE("no_ecc"),.MEMORY_INIT_FILE(FIRMWARE_INIT_FILE),
        .MEMORY_INIT_PARAM("0"),.MEMORY_OPTIMIZATION("true"),.MEMORY_PRIMITIVE("block"),
        .MEMORY_SIZE(32*(1<<RAM_ADDR_BITS)),.MESSAGE_CONTROL(0),.READ_DATA_WIDTH_A(32),
        .READ_LATENCY_A(1),.READ_RESET_VALUE_A("0"),.RST_MODE_A("SYNC"),.SIM_ASSERT_CHK(0),
        .USE_MEM_INIT(1),.WAKEUP_TIME("disable_sleep"),.WRITE_DATA_WIDTH_A(32),.WRITE_MODE_A("read_first")
    ) firmware_bram (
        .clka(clk),.ena(boot_write || boot_read),.addra(boot_addr),.dina(commit_data),
        .wea(boot_write ? commit_strb : 4'b0000),.douta(boot_rdata),
        .rsta(1'b0),.regcea(1'b1),.sleep(1'b0),.injectsbiterra(1'b0),.injectdbiterra(1'b0),
        .sbiterra(),.dbiterra()
    );
    end endgenerate
    always @(posedge clk) begin
        if(!resetn) begin
            local_aw_hold<=0;local_w_hold<=0;local_bvalid<=0;local_rvalid<=0;
            local_awaddr<=0;local_wdata<=0;local_wstrb<=0;
            local_rdata<=0;local_read_is_ram<=0;accel_read_pending<=0;
            for(i=0;i<16;i=i+1) debug_regs[i]<=0;
        end else begin
            if(local_aw_fire) begin local_aw_hold<=1;local_awaddr<=c_awaddr;end
            if(local_w_fire) begin local_w_hold<=1;local_wdata<=c_wdata;local_wstrb<=c_wstrb;end
            if(local_bvalid && c_bready) local_bvalid<=0;
            if(local_write_commit) begin
                local_aw_hold<=0;local_w_hold<=0;local_bvalid<=1;
                if(commit_addr[31:6]==DBG_BASE[31:6])
                    for(byte_i=0;byte_i<4;byte_i=byte_i+1)
                        if(commit_strb[byte_i]) debug_regs[commit_addr[5:2]][8*byte_i+:8]<=commit_data[8*byte_i+:8];
            end
            if(local_rvalid && c_rready) local_rvalid<=0;
            if(local_ar_fire) begin
                local_read_is_ram<=read_sel_ram;
                if(read_sel_acc) accel_read_pending<=1;
                else begin
                    local_rvalid<=1;
                    local_rdata<=read_sel_dbg ? debug_regs[c_araddr[5:2]] : 32'b0;
                end
            end
            // Native adapter rvalid is a pulse; capture it until AXI RREADY.
            if(accel_read_pending && accel_bus_rvalid) begin
                accel_read_pending<=0;local_rvalid<=1;local_read_is_ram<=0;
                local_rdata<=accel_bus_rdata;
            end
        end
    end
endmodule
