hongpengWu/mlkem-polymul-rv32i-fpga/results/keccak_cpu/pynq/20261004_psaxi04/bd_control_inputs/project/k4_pynq.gen/sources_1/bd/system/synth/system.v

//Copyright 1986-2022 Xilinx, Inc. All Rights Reserved.
//Copyright 2022-2024 Advanced Micro Devices, Inc. All Rights Reserved.
//--------------------------------------------------------------------------------
//Tool Version: Vivado v.2024.2 (win64) Build 5239630 Fri Nov 08 22:35:27 MST 2024
//Date        : Sun Oct  4 23:36:48 2026
//Host        : DESKTOP-H0SRFHK running 64-bit major release  (build 9200)
//Command     : generate_target system.bd
//Design      : system
//Purpose     : IP block netlist
//--------------------------------------------------------------------------------
`timescale 1 ps / 1 ps

module s00_couplers_imp_U8HEDN
   (M_ACLK,
    M_ARESETN,
    M_AXI_araddr,
    M_AXI_arprot,
    M_AXI_arready,
    M_AXI_arvalid,
    M_AXI_awaddr,
    M_AXI_awprot,
    M_AXI_awready,
    M_AXI_awvalid,
    M_AXI_bready,
    M_AXI_bresp,
    M_AXI_bvalid,
    M_AXI_rdata,
    M_AXI_rready,
    M_AXI_rresp,
    M_AXI_rvalid,
    M_AXI_wdata,
    M_AXI_wready,
    M_AXI_wstrb,
    M_AXI_wvalid,
    S_ACLK,
    S_ARESETN,
    S_AXI_araddr,
    S_AXI_arburst,
    S_AXI_arcache,
    S_AXI_arid,
    S_AXI_arlen,
    S_AXI_arlock,
    S_AXI_arprot,
    S_AXI_arqos,
    S_AXI_arready,
    S_AXI_arsize,
    S_AXI_arvalid,
    S_AXI_awaddr,
    S_AXI_awburst,
    S_AXI_awcache,
    S_AXI_awid,
    S_AXI_awlen,
    S_AXI_awlock,
    S_AXI_awprot,
    S_AXI_awqos,
    S_AXI_awready,
    S_AXI_awsize,
    S_AXI_awvalid,
    S_AXI_bid,
    S_AXI_bready,
    S_AXI_bresp,
    S_AXI_bvalid,
    S_AXI_rdata,
    S_AXI_rid,
    S_AXI_rlast,
    S_AXI_rready,
    S_AXI_rresp,
    S_AXI_rvalid,
    S_AXI_wdata,
    S_AXI_wid,
    S_AXI_wlast,
    S_AXI_wready,
    S_AXI_wstrb,
    S_AXI_wvalid);
  input M_ACLK;
  input M_ARESETN;
  output [31:0]M_AXI_araddr;
  output [2:0]M_AXI_arprot;
  input M_AXI_arready;
  output M_AXI_arvalid;
  output [31:0]M_AXI_awaddr;
  output [2:0]M_AXI_awprot;
  input M_AXI_awready;
  output M_AXI_awvalid;
  output M_AXI_bready;
  input [1:0]M_AXI_bresp;
  input M_AXI_bvalid;
  input [31:0]M_AXI_rdata;
  output M_AXI_rready;
  input [1:0]M_AXI_rresp;
  input M_AXI_rvalid;
  output [31:0]M_AXI_wdata;
  input M_AXI_wready;
  output [3:0]M_AXI_wstrb;
  output M_AXI_wvalid;
  input S_ACLK;
  input S_ARESETN;
  input [31:0]S_AXI_araddr;
  input [1:0]S_AXI_arburst;
  input [3:0]S_AXI_arcache;
  input [11:0]S_AXI_arid;
  input [3:0]S_AXI_arlen;
  input [1:0]S_AXI_arlock;
  input [2:0]S_AXI_arprot;
  input [3:0]S_AXI_arqos;
  output S_AXI_arready;
  input [2:0]S_AXI_arsize;
  input S_AXI_arvalid;
  input [31:0]S_AXI_awaddr;
  input [1:0]S_AXI_awburst;
  input [3:0]S_AXI_awcache;
  input [11:0]S_AXI_awid;
  input [3:0]S_AXI_awlen;
  input [1:0]S_AXI_awlock;
  input [2:0]S_AXI_awprot;
  input [3:0]S_AXI_awqos;
  output S_AXI_awready;
  input [2:0]S_AXI_awsize;
  input S_AXI_awvalid;
  output [11:0]S_AXI_bid;
  input S_AXI_bready;
  output [1:0]S_AXI_bresp;
  output S_AXI_bvalid;
  output [31:0]S_AXI_rdata;
  output [11:0]S_AXI_rid;
  output S_AXI_rlast;
  input S_AXI_rready;
  output [1:0]S_AXI_rresp;
  output S_AXI_rvalid;
  input [31:0]S_AXI_wdata;
  input [11:0]S_AXI_wid;
  input S_AXI_wlast;
  output S_AXI_wready;
  input [3:0]S_AXI_wstrb;
  input S_AXI_wvalid;

  wire [31:0]M_AXI_araddr;
  wire [2:0]M_AXI_arprot;
  wire M_AXI_arready;
  wire M_AXI_arvalid;
  wire [31:0]M_AXI_awaddr;
  wire [2:0]M_AXI_awprot;
  wire M_AXI_awready;
  wire M_AXI_awvalid;
  wire M_AXI_bready;
  wire [1:0]M_AXI_bresp;
  wire M_AXI_bvalid;
  wire [31:0]M_AXI_rdata;
  wire M_AXI_rready;
  wire [1:0]M_AXI_rresp;
  wire M_AXI_rvalid;
  wire [31:0]M_AXI_wdata;
  wire M_AXI_wready;
  wire [3:0]M_AXI_wstrb;
  wire M_AXI_wvalid;
  wire S_ACLK;
  wire S_ARESETN;
  wire [31:0]S_AXI_araddr;
  wire [1:0]S_AXI_arburst;
  wire [3:0]S_AXI_arcache;
  wire [11:0]S_AXI_arid;
  wire [3:0]S_AXI_arlen;
  wire [1:0]S_AXI_arlock;
  wire [2:0]S_AXI_arprot;
  wire [3:0]S_AXI_arqos;
  wire S_AXI_arready;
  wire [2:0]S_AXI_arsize;
  wire S_AXI_arvalid;
  wire [31:0]S_AXI_awaddr;
  wire [1:0]S_AXI_awburst;
  wire [3:0]S_AXI_awcache;
  wire [11:0]S_AXI_awid;
  wire [3:0]S_AXI_awlen;
  wire [1:0]S_AXI_awlock;
  wire [2:0]S_AXI_awprot;
  wire [3:0]S_AXI_awqos;
  wire S_AXI_awready;
  wire [2:0]S_AXI_awsize;
  wire S_AXI_awvalid;
  wire [11:0]S_AXI_bid;
  wire S_AXI_bready;
  wire [1:0]S_AXI_bresp;
  wire S_AXI_bvalid;
  wire [31:0]S_AXI_rdata;
  wire [11:0]S_AXI_rid;
  wire S_AXI_rlast;
  wire S_AXI_rready;
  wire [1:0]S_AXI_rresp;
  wire S_AXI_rvalid;
  wire [31:0]S_AXI_wdata;
  wire [11:0]S_AXI_wid;
  wire S_AXI_wlast;
  wire S_AXI_wready;
  wire [3:0]S_AXI_wstrb;
  wire S_AXI_wvalid;

  system_axi_bus_imp_auto_pc_0 auto_pc
       (.aclk(S_ACLK),
        .aresetn(S_ARESETN),
        .m_axi_araddr(M_AXI_araddr),
        .m_axi_arprot(M_AXI_arprot),
        .m_axi_arready(M_AXI_arready),
        .m_axi_arvalid(M_AXI_arvalid),
        .m_axi_awaddr(M_AXI_awaddr),
        .m_axi_awprot(M_AXI_awprot),
        .m_axi_awready(M_AXI_awready),
        .m_axi_awvalid(M_AXI_awvalid),
        .m_axi_bready(M_AXI_bready),
        .m_axi_bresp(M_AXI_bresp),
        .m_axi_bvalid(M_AXI_bvalid),
        .m_axi_rdata(M_AXI_rdata),
        .m_axi_rready(M_AXI_rready),
        .m_axi_rresp(M_AXI_rresp),
        .m_axi_rvalid(M_AXI_rvalid),
        .m_axi_wdata(M_AXI_wdata),
        .m_axi_wready(M_AXI_wready),
        .m_axi_wstrb(M_AXI_wstrb),
        .m_axi_wvalid(M_AXI_wvalid),
        .s_axi_araddr(S_AXI_araddr),
        .s_axi_arburst(S_AXI_arburst),
        .s_axi_arcache(S_AXI_arcache),
        .s_axi_arid(S_AXI_arid),
        .s_axi_arlen(S_AXI_arlen),
        .s_axi_arlock(S_AXI_arlock),
        .s_axi_arprot(S_AXI_arprot),
        .s_axi_arqos(S_AXI_arqos),
        .s_axi_arready(S_AXI_arready),
        .s_axi_arsize(S_AXI_arsize),
        .s_axi_arvalid(S_AXI_arvalid),
        .s_axi_awaddr(S_AXI_awaddr),
        .s_axi_awburst(S_AXI_awburst),
        .s_axi_awcache(S_AXI_awcache),
        .s_axi_awid(S_AXI_awid),
        .s_axi_awlen(S_AXI_awlen),
        .s_axi_awlock(S_AXI_awlock),
        .s_axi_awprot(S_AXI_awprot),
        .s_axi_awqos(S_AXI_awqos),
        .s_axi_awready(S_AXI_awready),
        .s_axi_awsize(S_AXI_awsize),
        .s_axi_awvalid(S_AXI_awvalid),
        .s_axi_bid(S_AXI_bid),
        .s_axi_bready(S_AXI_bready),
        .s_axi_bresp(S_AXI_bresp),
        .s_axi_bvalid(S_AXI_bvalid),
        .s_axi_rdata(S_AXI_rdata),
        .s_axi_rid(S_AXI_rid),
        .s_axi_rlast(S_AXI_rlast),
        .s_axi_rready(S_AXI_rready),
        .s_axi_rresp(S_AXI_rresp),
        .s_axi_rvalid(S_AXI_rvalid),
        .s_axi_wdata(S_AXI_wdata),
        .s_axi_wid(S_AXI_wid),
        .s_axi_wlast(S_AXI_wlast),
        .s_axi_wready(S_AXI_wready),
        .s_axi_wstrb(S_AXI_wstrb),
        .s_axi_wvalid(S_AXI_wvalid));
endmodule

(* CORE_GENERATION_INFO = "system,IP_Integrator,{x_ipVendor=xilinx.com,x_ipLibrary=BlockDiagram,x_ipName=system,x_ipVersion=1.00.a,x_ipLanguage=VERILOG,numBlks=8,numReposBlks=6,numNonXlnxBlks=0,numHierBlks=2,maxHierDepth=0,numSysgenBlks=0,numHlsBlks=0,numHdlrefBlks=1,numPkgbdBlks=0,bdsource=USER,da_ps7_cnt=1,synth_mode=Hierarchical}" *) (* HW_HANDOFF = "system.hwdef" *) 
module system
   (DDR_addr,
    DDR_ba,
    DDR_cas_n,
    DDR_ck_n,
    DDR_ck_p,
    DDR_cke,
    DDR_cs_n,
    DDR_dm,
    DDR_dq,
    DDR_dqs_n,
    DDR_dqs_p,
    DDR_odt,
    DDR_ras_n,
    DDR_reset_n,
    DDR_we_n,
    FIXED_IO_ddr_vrn,
    FIXED_IO_ddr_vrp,
    FIXED_IO_mio,
    FIXED_IO_ps_clk,
    FIXED_IO_ps_porb,
    FIXED_IO_ps_srstb,
    led);
  (* X_INTERFACE_INFO = "xilinx.com:interface:ddrx:1.0 DDR ADDR" *) (* X_INTERFACE_MODE = "Master" *) (* X_INTERFACE_PARAMETER = "XIL_INTERFACENAME DDR, AXI_ARBITRATION_SCHEME TDM, BURST_LENGTH 8, CAN_DEBUG false, CAS_LATENCY 11, CAS_WRITE_LATENCY 11, CS_ENABLED true, DATA_MASK_ENABLED true, DATA_WIDTH 8, MEMORY_TYPE COMPONENTS, MEM_ADDR_MAP ROW_COLUMN_BANK, SLOT Single, TIMEPERIOD_PS 1250" *) inout [14:0]DDR_addr;
  (* X_INTERFACE_INFO = "xilinx.com:interface:ddrx:1.0 DDR BA" *) inout [2:0]DDR_ba;
  (* X_INTERFACE_INFO = "xilinx.com:interface:ddrx:1.0 DDR CAS_N" *) inout DDR_cas_n;
  (* X_INTERFACE_INFO = "xilinx.com:interface:ddrx:1.0 DDR CK_N" *) inout DDR_ck_n;
  (* X_INTERFACE_INFO = "xilinx.com:interface:ddrx:1.0 DDR CK_P" *) inout DDR_ck_p;
  (* X_INTERFACE_INFO = "xilinx.com:interface:ddrx:1.0 DDR CKE" *) inout DDR_cke;
  (* X_INTERFACE_INFO = "xilinx.com:interface:ddrx:1.0 DDR CS_N" *) inout DDR_cs_n;
  (* X_INTERFACE_INFO = "xilinx.com:interface:ddrx:1.0 DDR DM" *) inout [3:0]DDR_dm;
  (* X_INTERFACE_INFO = "xilinx.com:interface:ddrx:1.0 DDR DQ" *) inout [31:0]DDR_dq;
  (* X_INTERFACE_INFO = "xilinx.com:interface:ddrx:1.0 DDR DQS_N" *) inout [3:0]DDR_dqs_n;
  (* X_INTERFACE_INFO = "xilinx.com:interface:ddrx:1.0 DDR DQS_P" *) inout [3:0]DDR_dqs_p;
  (* X_INTERFACE_INFO = "xilinx.com:interface:ddrx:1.0 DDR ODT" *) inout DDR_odt;
  (* X_INTERFACE_INFO = "xilinx.com:interface:ddrx:1.0 DDR RAS_N" *) inout DDR_ras_n;
  (* X_INTERFACE_INFO = "xilinx.com:interface:ddrx:1.0 DDR RESET_N" *) inout DDR_reset_n;
  (* X_INTERFACE_INFO = "xilinx.com:interface:ddrx:1.0 DDR WE_N" *) inout DDR_we_n;
  (* X_INTERFACE_INFO = "xilinx.com:display_processing_system7:fixedio:1.0 FIXED_IO DDR_VRN" *) (* X_INTERFACE_MODE = "Master" *) (* X_INTERFACE_PARAMETER = "XIL_INTERFACENAME FIXED_IO, CAN_DEBUG false" *) inout FIXED_IO_ddr_vrn;
  (* X_INTERFACE_INFO = "xilinx.com:display_processing_system7:fixedio:1.0 FIXED_IO DDR_VRP" *) inout FIXED_IO_ddr_vrp;
  (* X_INTERFACE_INFO = "xilinx.com:display_processing_system7:fixedio:1.0 FIXED_IO MIO" *) inout [53:0]FIXED_IO_mio;
  (* X_INTERFACE_INFO = "xilinx.com:display_processing_system7:fixedio:1.0 FIXED_IO PS_CLK" *) inout FIXED_IO_ps_clk;
  (* X_INTERFACE_INFO = "xilinx.com:display_processing_system7:fixedio:1.0 FIXED_IO PS_PORB" *) inout FIXED_IO_ps_porb;
  (* X_INTERFACE_INFO = "xilinx.com:display_processing_system7:fixedio:1.0 FIXED_IO PS_SRSTB" *) inout FIXED_IO_ps_srstb;
  output [3:0]led;

  wire [14:0]DDR_addr;
  wire [2:0]DDR_ba;
  wire DDR_cas_n;
  wire DDR_ck_n;
  wire DDR_ck_p;
  wire DDR_cke;
  wire DDR_cs_n;
  wire [3:0]DDR_dm;
  wire [31:0]DDR_dq;
  wire [3:0]DDR_dqs_n;
  wire [3:0]DDR_dqs_p;
  wire DDR_odt;
  wire DDR_ras_n;
  wire DDR_reset_n;
  wire DDR_we_n;
  wire FIXED_IO_ddr_vrn;
  wire FIXED_IO_ddr_vrp;
  wire [53:0]FIXED_IO_mio;
  wire FIXED_IO_ps_clk;
  wire FIXED_IO_ps_porb;
  wire FIXED_IO_ps_srstb;
  wire [31:0]axi_bus_M00_AXI_ARADDR;
  wire [2:0]axi_bus_M00_AXI_ARPROT;
  wire axi_bus_M00_AXI_ARREADY;
  wire axi_bus_M00_AXI_ARVALID;
  wire [31:0]axi_bus_M00_AXI_AWADDR;
  wire [2:0]axi_bus_M00_AXI_AWPROT;
  wire axi_bus_M00_AXI_AWREADY;
  wire axi_bus_M00_AXI_AWVALID;
  wire axi_bus_M00_AXI_BREADY;
  wire [1:0]axi_bus_M00_AXI_BRESP;
  wire axi_bus_M00_AXI_BVALID;
  wire [31:0]axi_bus_M00_AXI_RDATA;
  wire axi_bus_M00_AXI_RREADY;
  wire [1:0]axi_bus_M00_AXI_RRESP;
  wire axi_bus_M00_AXI_RVALID;
  wire [31:0]axi_bus_M00_AXI_WDATA;
  wire axi_bus_M00_AXI_WREADY;
  wire [3:0]axi_bus_M00_AXI_WSTRB;
  wire axi_bus_M00_AXI_WVALID;
  wire [3:0]led;
  wire [0:0]locked_one_dout;
  wire ps7_FCLK_CLK0;
  wire ps7_FCLK_RESET0_N;
  wire [31:0]ps7_M_AXI_GP0_ARADDR;
  wire [1:0]ps7_M_AXI_GP0_ARBURST;
  wire [3:0]ps7_M_AXI_GP0_ARCACHE;
  wire [11:0]ps7_M_AXI_GP0_ARID;
  wire [3:0]ps7_M_AXI_GP0_ARLEN;
  wire [1:0]ps7_M_AXI_GP0_ARLOCK;
  wire [2:0]ps7_M_AXI_GP0_ARPROT;
  wire [3:0]ps7_M_AXI_GP0_ARQOS;
  wire ps7_M_AXI_GP0_ARREADY;
  wire [2:0]ps7_M_AXI_GP0_ARSIZE;
  wire ps7_M_AXI_GP0_ARVALID;
  wire [31:0]ps7_M_AXI_GP0_AWADDR;
  wire [1:0]ps7_M_AXI_GP0_AWBURST;
  wire [3:0]ps7_M_AXI_GP0_AWCACHE;
  wire [11:0]ps7_M_AXI_GP0_AWID;
  wire [3:0]ps7_M_AXI_GP0_AWLEN;
  wire [1:0]ps7_M_AXI_GP0_AWLOCK;
  wire [2:0]ps7_M_AXI_GP0_AWPROT;
  wire [3:0]ps7_M_AXI_GP0_AWQOS;
  wire ps7_M_AXI_GP0_AWREADY;
  wire [2:0]ps7_M_AXI_GP0_AWSIZE;
  wire ps7_M_AXI_GP0_AWVALID;
  wire [11:0]ps7_M_AXI_GP0_BID;
  wire ps7_M_AXI_GP0_BREADY;
  wire [1:0]ps7_M_AXI_GP0_BRESP;
  wire ps7_M_AXI_GP0_BVALID;
  wire [31:0]ps7_M_AXI_GP0_RDATA;
  wire [11:0]ps7_M_AXI_GP0_RID;
  wire ps7_M_AXI_GP0_RLAST;
  wire ps7_M_AXI_GP0_RREADY;
  wire [1:0]ps7_M_AXI_GP0_RRESP;
  wire ps7_M_AXI_GP0_RVALID;
  wire [31:0]ps7_M_AXI_GP0_WDATA;
  wire [11:0]ps7_M_AXI_GP0_WID;
  wire ps7_M_AXI_GP0_WLAST;
  wire ps7_M_AXI_GP0_WREADY;
  wire [3:0]ps7_M_AXI_GP0_WSTRB;
  wire ps7_M_AXI_GP0_WVALID;
  wire [0:0]reset_100m_interconnect_aresetn;
  wire [0:0]reset_100m_peripheral_aresetn;
  wire [0:0]reset_zero_dout;

  system_axi_bus_0 axi_bus
       (.ACLK(ps7_FCLK_CLK0),
        .ARESETN(reset_100m_interconnect_aresetn),
        .M00_ACLK(ps7_FCLK_CLK0),
        .M00_ARESETN(reset_100m_peripheral_aresetn),
        .M00_AXI_araddr(axi_bus_M00_AXI_ARADDR),
        .M00_AXI_arprot(axi_bus_M00_AXI_ARPROT),
        .M00_AXI_arready(axi_bus_M00_AXI_ARREADY),
        .M00_AXI_arvalid(axi_bus_M00_AXI_ARVALID),
        .M00_AXI_awaddr(axi_bus_M00_AXI_AWADDR),
        .M00_AXI_awprot(axi_bus_M00_AXI_AWPROT),
        .M00_AXI_awready(axi_bus_M00_AXI_AWREADY),
        .M00_AXI_awvalid(axi_bus_M00_AXI_AWVALID),
        .M00_AXI_bready(axi_bus_M00_AXI_BREADY),
        .M00_AXI_bresp(axi_bus_M00_AXI_BRESP),
        .M00_AXI_bvalid(axi_bus_M00_AXI_BVALID),
        .M00_AXI_rdata(axi_bus_M00_AXI_RDATA),
        .M00_AXI_rready(axi_bus_M00_AXI_RREADY),
        .M00_AXI_rresp(axi_bus_M00_AXI_RRESP),
        .M00_AXI_rvalid(axi_bus_M00_AXI_RVALID),
        .M00_AXI_wdata(axi_bus_M00_AXI_WDATA),
        .M00_AXI_wready(axi_bus_M00_AXI_WREADY),
        .M00_AXI_wstrb(axi_bus_M00_AXI_WSTRB),
        .M00_AXI_wvalid(axi_bus_M00_AXI_WVALID),
        .S00_ACLK(ps7_FCLK_CLK0),
        .S00_ARESETN(reset_100m_peripheral_aresetn),
        .S00_AXI_araddr(ps7_M_AXI_GP0_ARADDR),
        .S00_AXI_arburst(ps7_M_AXI_GP0_ARBURST),
        .S00_AXI_arcache(ps7_M_AXI_GP0_ARCACHE),
        .S00_AXI_arid(ps7_M_AXI_GP0_ARID),
        .S00_AXI_arlen(ps7_M_AXI_GP0_ARLEN),
        .S00_AXI_arlock(ps7_M_AXI_GP0_ARLOCK),
        .S00_AXI_arprot(ps7_M_AXI_GP0_ARPROT),
        .S00_AXI_arqos(ps7_M_AXI_GP0_ARQOS),
        .S00_AXI_arready(ps7_M_AXI_GP0_ARREADY),
        .S00_AXI_arsize(ps7_M_AXI_GP0_ARSIZE),
        .S00_AXI_arvalid(ps7_M_AXI_GP0_ARVALID),
        .S00_AXI_awaddr(ps7_M_AXI_GP0_AWADDR),
        .S00_AXI_awburst(ps7_M_AXI_GP0_AWBURST),
        .S00_AXI_awcache(ps7_M_AXI_GP0_AWCACHE),
        .S00_AXI_awid(ps7_M_AXI_GP0_AWID),
        .S00_AXI_awlen(ps7_M_AXI_GP0_AWLEN),
        .S00_AXI_awlock(ps7_M_AXI_GP0_AWLOCK),
        .S00_AXI_awprot(ps7_M_AXI_GP0_AWPROT),
        .S00_AXI_awqos(ps7_M_AXI_GP0_AWQOS),
        .S00_AXI_awready(ps7_M_AXI_GP0_AWREADY),
        .S00_AXI_awsize(ps7_M_AXI_GP0_AWSIZE),
        .S00_AXI_awvalid(ps7_M_AXI_GP0_AWVALID),
        .S00_AXI_bid(ps7_M_AXI_GP0_BID),
        .S00_AXI_bready(ps7_M_AXI_GP0_BREADY),
        .S00_AXI_bresp(ps7_M_AXI_GP0_BRESP),
        .S00_AXI_bvalid(ps7_M_AXI_GP0_BVALID),
        .S00_AXI_rdata(ps7_M_AXI_GP0_RDATA),
        .S00_AXI_rid(ps7_M_AXI_GP0_RID),
        .S00_AXI_rlast(ps7_M_AXI_GP0_RLAST),
        .S00_AXI_rready(ps7_M_AXI_GP0_RREADY),
        .S00_AXI_rresp(ps7_M_AXI_GP0_RRESP),
        .S00_AXI_rvalid(ps7_M_AXI_GP0_RVALID),
        .S00_AXI_wdata(ps7_M_AXI_GP0_WDATA),
        .S00_AXI_wid(ps7_M_AXI_GP0_WID),
        .S00_AXI_wlast(ps7_M_AXI_GP0_WLAST),
        .S00_AXI_wready(ps7_M_AXI_GP0_WREADY),
        .S00_AXI_wstrb(ps7_M_AXI_GP0_WSTRB),
        .S00_AXI_wvalid(ps7_M_AXI_GP0_WVALID));
  system_k4_core_0 k4_core
       (.led(led),
        .s_axi_aclk(ps7_FCLK_CLK0),
        .s_axi_araddr(axi_bus_M00_AXI_ARADDR[17:0]),
        .s_axi_aresetn(reset_100m_peripheral_aresetn),
        .s_axi_arprot(axi_bus_M00_AXI_ARPROT),
        .s_axi_arready(axi_bus_M00_AXI_ARREADY),
        .s_axi_arvalid(axi_bus_M00_AXI_ARVALID),
        .s_axi_awaddr(axi_bus_M00_AXI_AWADDR[17:0]),
        .s_axi_awprot(axi_bus_M00_AXI_AWPROT),
        .s_axi_awready(axi_bus_M00_AXI_AWREADY),
        .s_axi_awvalid(axi_bus_M00_AXI_AWVALID),
        .s_axi_bready(axi_bus_M00_AXI_BREADY),
        .s_axi_bresp(axi_bus_M00_AXI_BRESP),
        .s_axi_bvalid(axi_bus_M00_AXI_BVALID),
        .s_axi_rdata(axi_bus_M00_AXI_RDATA),
        .s_axi_rready(axi_bus_M00_AXI_RREADY),
        .s_axi_rresp(axi_bus_M00_AXI_RRESP),
        .s_axi_rvalid(axi_bus_M00_AXI_RVALID),
        .s_axi_wdata(axi_bus_M00_AXI_WDATA),
        .s_axi_wready(axi_bus_M00_AXI_WREADY),
        .s_axi_wstrb(axi_bus_M00_AXI_WSTRB),
        .s_axi_wvalid(axi_bus_M00_AXI_WVALID));
  system_locked_one_0 locked_one
       (.dout(locked_one_dout));
  system_ps7_0 ps7
       (.DDR_Addr(DDR_addr),
        .DDR_BankAddr(DDR_ba),
        .DDR_CAS_n(DDR_cas_n),
        .DDR_CKE(DDR_cke),
        .DDR_CS_n(DDR_cs_n),
        .DDR_Clk(DDR_ck_p),
        .DDR_Clk_n(DDR_ck_n),
        .DDR_DM(DDR_dm),
        .DDR_DQ(DDR_dq),
        .DDR_DQS(DDR_dqs_p),
        .DDR_DQS_n(DDR_dqs_n),
        .DDR_DRSTB(DDR_reset_n),
        .DDR_ODT(DDR_odt),
        .DDR_RAS_n(DDR_ras_n),
        .DDR_VRN(FIXED_IO_ddr_vrn),
        .DDR_VRP(FIXED_IO_ddr_vrp),
        .DDR_WEB(DDR_we_n),
        .FCLK_CLK0(ps7_FCLK_CLK0),
        .FCLK_RESET0_N(ps7_FCLK_RESET0_N),
        .MIO(FIXED_IO_mio),
        .M_AXI_GP0_ACLK(ps7_FCLK_CLK0),
        .M_AXI_GP0_ARADDR(ps7_M_AXI_GP0_ARADDR),
        .M_AXI_GP0_ARBURST(ps7_M_AXI_GP0_ARBURST),
        .M_AXI_GP0_ARCACHE(ps7_M_AXI_GP0_ARCACHE),
        .M_AXI_GP0_ARID(ps7_M_AXI_GP0_ARID),
        .M_AXI_GP0_ARLEN(ps7_M_AXI_GP0_ARLEN),
        .M_AXI_GP0_ARLOCK(ps7_M_AXI_GP0_ARLOCK),
        .M_AXI_GP0_ARPROT(ps7_M_AXI_GP0_ARPROT),
        .M_AXI_GP0_ARQOS(ps7_M_AXI_GP0_ARQOS),
        .M_AXI_GP0_ARREADY(ps7_M_AXI_GP0_ARREADY),
        .M_AXI_GP0_ARSIZE(ps7_M_AXI_GP0_ARSIZE),
        .M_AXI_GP0_ARVALID(ps7_M_AXI_GP0_ARVALID),
        .M_AXI_GP0_AWADDR(ps7_M_AXI_GP0_AWADDR),
        .M_AXI_GP0_AWBURST(ps7_M_AXI_GP0_AWBURST),
        .M_AXI_GP0_AWCACHE(ps7_M_AXI_GP0_AWCACHE),
        .M_AXI_GP0_AWID(ps7_M_AXI_GP0_AWID),
        .M_AXI_GP0_AWLEN(ps7_M_AXI_GP0_AWLEN),
        .M_AXI_GP0_AWLOCK(ps7_M_AXI_GP0_AWLOCK),
        .M_AXI_GP0_AWPROT(ps7_M_AXI_GP0_AWPROT),
        .M_AXI_GP0_AWQOS(ps7_M_AXI_GP0_AWQOS),
        .M_AXI_GP0_AWREADY(ps7_M_AXI_GP0_AWREADY),
        .M_AXI_GP0_AWSIZE(ps7_M_AXI_GP0_AWSIZE),
        .M_AXI_GP0_AWVALID(ps7_M_AXI_GP0_AWVALID),
        .M_AXI_GP0_BID(ps7_M_AXI_GP0_BID),
        .M_AXI_GP0_BREADY(ps7_M_AXI_GP0_BREADY),
        .M_AXI_GP0_BRESP(ps7_M_AXI_GP0_BRESP),
        .M_AXI_GP0_BVALID(ps7_M_AXI_GP0_BVALID),
        .M_AXI_GP0_RDATA(ps7_M_AXI_GP0_RDATA),
        .M_AXI_GP0_RID(ps7_M_AXI_GP0_RID),
        .M_AXI_GP0_RLAST(ps7_M_AXI_GP0_RLAST),
        .M_AXI_GP0_RREADY(ps7_M_AXI_GP0_RREADY),
        .M_AXI_GP0_RRESP(ps7_M_AXI_GP0_RRESP),
        .M_AXI_GP0_RVALID(ps7_M_AXI_GP0_RVALID),
        .M_AXI_GP0_WDATA(ps7_M_AXI_GP0_WDATA),
        .M_AXI_GP0_WID(ps7_M_AXI_GP0_WID),
        .M_AXI_GP0_WLAST(ps7_M_AXI_GP0_WLAST),
        .M_AXI_GP0_WREADY(ps7_M_AXI_GP0_WREADY),
        .M_AXI_GP0_WSTRB(ps7_M_AXI_GP0_WSTRB),
        .M_AXI_GP0_WVALID(ps7_M_AXI_GP0_WVALID),
        .PS_CLK(FIXED_IO_ps_clk),
        .PS_PORB(FIXED_IO_ps_porb),
        .PS_SRSTB(FIXED_IO_ps_srstb),
        .USB0_VBUS_PWRFAULT(1'b0));
  system_reset_100m_0 reset_100m
       (.aux_reset_in(reset_zero_dout),
        .dcm_locked(locked_one_dout),
        .ext_reset_in(ps7_FCLK_RESET0_N),
        .interconnect_aresetn(reset_100m_interconnect_aresetn),
        .mb_debug_sys_rst(reset_zero_dout),
        .peripheral_aresetn(reset_100m_peripheral_aresetn),
        .slowest_sync_clk(ps7_FCLK_CLK0));
  system_reset_zero_0 reset_zero
       (.dout(reset_zero_dout));
endmodule

module system_axi_bus_0
   (ACLK,
    ARESETN,
    M00_ACLK,
    M00_ARESETN,
    M00_AXI_araddr,
    M00_AXI_arprot,
    M00_AXI_arready,
    M00_AXI_arvalid,
    M00_AXI_awaddr,
    M00_AXI_awprot,
    M00_AXI_awready,
    M00_AXI_awvalid,
    M00_AXI_bready,
    M00_AXI_bresp,
    M00_AXI_bvalid,
    M00_AXI_rdata,
    M00_AXI_rready,
    M00_AXI_rresp,
    M00_AXI_rvalid,
    M00_AXI_wdata,
    M00_AXI_wready,
    M00_AXI_wstrb,
    M00_AXI_wvalid,
    S00_ACLK,
    S00_ARESETN,
    S00_AXI_araddr,
    S00_AXI_arburst,
    S00_AXI_arcache,
    S00_AXI_arid,
    S00_AXI_arlen,
    S00_AXI_arlock,
    S00_AXI_arprot,
    S00_AXI_arqos,
    S00_AXI_arready,
    S00_AXI_arsize,
    S00_AXI_arvalid,
    S00_AXI_awaddr,
    S00_AXI_awburst,
    S00_AXI_awcache,
    S00_AXI_awid,
    S00_AXI_awlen,
    S00_AXI_awlock,
    S00_AXI_awprot,
    S00_AXI_awqos,
    S00_AXI_awready,
    S00_AXI_awsize,
    S00_AXI_awvalid,
    S00_AXI_bid,
    S00_AXI_bready,
    S00_AXI_bresp,
    S00_AXI_bvalid,
    S00_AXI_rdata,
    S00_AXI_rid,
    S00_AXI_rlast,
    S00_AXI_rready,
    S00_AXI_rresp,
    S00_AXI_rvalid,
    S00_AXI_wdata,
    S00_AXI_wid,
    S00_AXI_wlast,
    S00_AXI_wready,
    S00_AXI_wstrb,
    S00_AXI_wvalid);
  input ACLK;
  input ARESETN;
  input M00_ACLK;
  input M00_ARESETN;
  output [31:0]M00_AXI_araddr;
  output [2:0]M00_AXI_arprot;
  input M00_AXI_arready;
  output M00_AXI_arvalid;
  output [31:0]M00_AXI_awaddr;
  output [2:0]M00_AXI_awprot;
  input M00_AXI_awready;
  output M00_AXI_awvalid;
  output M00_AXI_bready;
  input [1:0]M00_AXI_bresp;
  input M00_AXI_bvalid;
  input [31:0]M00_AXI_rdata;
  output M00_AXI_rready;
  input [1:0]M00_AXI_rresp;
  input M00_AXI_rvalid;
  output [31:0]M00_AXI_wdata;
  input M00_AXI_wready;
  output [3:0]M00_AXI_wstrb;
  output M00_AXI_wvalid;
  input S00_ACLK;
  input S00_ARESETN;
  input [31:0]S00_AXI_araddr;
  input [1:0]S00_AXI_arburst;
  input [3:0]S00_AXI_arcache;
  input [11:0]S00_AXI_arid;
  input [3:0]S00_AXI_arlen;
  input [1:0]S00_AXI_arlock;
  input [2:0]S00_AXI_arprot;
  input [3:0]S00_AXI_arqos;
  output S00_AXI_arready;
  input [2:0]S00_AXI_arsize;
  input S00_AXI_arvalid;
  input [31:0]S00_AXI_awaddr;
  input [1:0]S00_AXI_awburst;
  input [3:0]S00_AXI_awcache;
  input [11:0]S00_AXI_awid;
  input [3:0]S00_AXI_awlen;
  input [1:0]S00_AXI_awlock;
  input [2:0]S00_AXI_awprot;
  input [3:0]S00_AXI_awqos;
  output S00_AXI_awready;
  input [2:0]S00_AXI_awsize;
  input S00_AXI_awvalid;
  output [11:0]S00_AXI_bid;
  input S00_AXI_bready;
  output [1:0]S00_AXI_bresp;
  output S00_AXI_bvalid;
  output [31:0]S00_AXI_rdata;
  output [11:0]S00_AXI_rid;
  output S00_AXI_rlast;
  input S00_AXI_rready;
  output [1:0]S00_AXI_rresp;
  output S00_AXI_rvalid;
  input [31:0]S00_AXI_wdata;
  input [11:0]S00_AXI_wid;
  input S00_AXI_wlast;
  output S00_AXI_wready;
  input [3:0]S00_AXI_wstrb;
  input S00_AXI_wvalid;

  wire M00_ACLK;
  wire M00_ARESETN;
  wire [31:0]M00_AXI_araddr;
  wire [2:0]M00_AXI_arprot;
  wire M00_AXI_arready;
  wire M00_AXI_arvalid;
  wire [31:0]M00_AXI_awaddr;
  wire [2:0]M00_AXI_awprot;
  wire M00_AXI_awready;
  wire M00_AXI_awvalid;
  wire M00_AXI_bready;
  wire [1:0]M00_AXI_bresp;
  wire M00_AXI_bvalid;
  wire [31:0]M00_AXI_rdata;
  wire M00_AXI_rready;
  wire [1:0]M00_AXI_rresp;
  wire M00_AXI_rvalid;
  wire [31:0]M00_AXI_wdata;
  wire M00_AXI_wready;
  wire [3:0]M00_AXI_wstrb;
  wire M00_AXI_wvalid;
  wire S00_ACLK;
  wire S00_ARESETN;
  wire [31:0]S00_AXI_araddr;
  wire [1:0]S00_AXI_arburst;
  wire [3:0]S00_AXI_arcache;
  wire [11:0]S00_AXI_arid;
  wire [3:0]S00_AXI_arlen;
  wire [1:0]S00_AXI_arlock;
  wire [2:0]S00_AXI_arprot;
  wire [3:0]S00_AXI_arqos;
  wire S00_AXI_arready;
  wire [2:0]S00_AXI_arsize;
  wire S00_AXI_arvalid;
  wire [31:0]S00_AXI_awaddr;
  wire [1:0]S00_AXI_awburst;
  wire [3:0]S00_AXI_awcache;
  wire [11:0]S00_AXI_awid;
  wire [3:0]S00_AXI_awlen;
  wire [1:0]S00_AXI_awlock;
  wire [2:0]S00_AXI_awprot;
  wire [3:0]S00_AXI_awqos;
  wire S00_AXI_awready;
  wire [2:0]S00_AXI_awsize;
  wire S00_AXI_awvalid;
  wire [11:0]S00_AXI_bid;
  wire S00_AXI_bready;
  wire [1:0]S00_AXI_bresp;
  wire S00_AXI_bvalid;
  wire [31:0]S00_AXI_rdata;
  wire [11:0]S00_AXI_rid;
  wire S00_AXI_rlast;
  wire S00_AXI_rready;
  wire [1:0]S00_AXI_rresp;
  wire S00_AXI_rvalid;
  wire [31:0]S00_AXI_wdata;
  wire [11:0]S00_AXI_wid;
  wire S00_AXI_wlast;
  wire S00_AXI_wready;
  wire [3:0]S00_AXI_wstrb;
  wire S00_AXI_wvalid;

  s00_couplers_imp_U8HEDN s00_couplers
       (.M_ACLK(M00_ACLK),
        .M_ARESETN(M00_ARESETN),
        .M_AXI_araddr(M00_AXI_araddr),
        .M_AXI_arprot(M00_AXI_arprot),
        .M_AXI_arready(M00_AXI_arready),
        .M_AXI_arvalid(M00_AXI_arvalid),
        .M_AXI_awaddr(M00_AXI_awaddr),
        .M_AXI_awprot(M00_AXI_awprot),
        .M_AXI_awready(M00_AXI_awready),
        .M_AXI_awvalid(M00_AXI_awvalid),
        .M_AXI_bready(M00_AXI_bready),
        .M_AXI_bresp(M00_AXI_bresp),
        .M_AXI_bvalid(M00_AXI_bvalid),
        .M_AXI_rdata(M00_AXI_rdata),
        .M_AXI_rready(M00_AXI_rready),
        .M_AXI_rresp(M00_AXI_rresp),
        .M_AXI_rvalid(M00_AXI_rvalid),
        .M_AXI_wdata(M00_AXI_wdata),
        .M_AXI_wready(M00_AXI_wready),
        .M_AXI_wstrb(M00_AXI_wstrb),
        .M_AXI_wvalid(M00_AXI_wvalid),
        .S_ACLK(S00_ACLK),
        .S_ARESETN(S00_ARESETN),
        .S_AXI_araddr(S00_AXI_araddr),
        .S_AXI_arburst(S00_AXI_arburst),
        .S_AXI_arcache(S00_AXI_arcache),
        .S_AXI_arid(S00_AXI_arid),
        .S_AXI_arlen(S00_AXI_arlen),
        .S_AXI_arlock(S00_AXI_arlock),
        .S_AXI_arprot(S00_AXI_arprot),
        .S_AXI_arqos(S00_AXI_arqos),
        .S_AXI_arready(S00_AXI_arready),
        .S_AXI_arsize(S00_AXI_arsize),
        .S_AXI_arvalid(S00_AXI_arvalid),
        .S_AXI_awaddr(S00_AXI_awaddr),
        .S_AXI_awburst(S00_AXI_awburst),
        .S_AXI_awcache(S00_AXI_awcache),
        .S_AXI_awid(S00_AXI_awid),
        .S_AXI_awlen(S00_AXI_awlen),
        .S_AXI_awlock(S00_AXI_awlock),
        .S_AXI_awprot(S00_AXI_awprot),
        .S_AXI_awqos(S00_AXI_awqos),
        .S_AXI_awready(S00_AXI_awready),
        .S_AXI_awsize(S00_AXI_awsize),
        .S_AXI_awvalid(S00_AXI_awvalid),
        .S_AXI_bid(S00_AXI_bid),
        .S_AXI_bready(S00_AXI_bready),
        .S_AXI_bresp(S00_AXI_bresp),
        .S_AXI_bvalid(S00_AXI_bvalid),
        .S_AXI_rdata(S00_AXI_rdata),
        .S_AXI_rid(S00_AXI_rid),
        .S_AXI_rlast(S00_AXI_rlast),
        .S_AXI_rready(S00_AXI_rready),
        .S_AXI_rresp(S00_AXI_rresp),
        .S_AXI_rvalid(S00_AXI_rvalid),
        .S_AXI_wdata(S00_AXI_wdata),
        .S_AXI_wid(S00_AXI_wid),
        .S_AXI_wlast(S00_AXI_wlast),
        .S_AXI_wready(S00_AXI_wready),
        .S_AXI_wstrb(S00_AXI_wstrb),
        .S_AXI_wvalid(S00_AXI_wvalid));
endmodule
