hongpengWu/mlkem-polymul-rv32i-fpga/tb/accelerator/tb_mlkem1024_keccak_kat.sv

`timescale 1ns/1ps

// Official inputs enter only through a simulator-host mailbox. Expected outputs
// remain in this testbench; the CPU executes the full KEM with hardware FIPS202.
module tb_mlkem1024_keccak_kat;
  parameter integer CPU_ENABLE_MUL=1;
  parameter integer CPU_ENABLE_FAST_MUL=1;
  parameter integer CPU_ENABLE_DIV=1;
  parameter integer EXPECT_M=1;
  parameter integer EXPECTED_CASES=145;
  parameter integer TIMEOUT_CYCLES=100000000;
  parameter integer PARAMETER_SET=1024;
  parameter integer RAM_ADDR_BITS=15;
  parameter integer STACK_BYTES=32768;
  parameter FIRMWARE_INIT_FILE="mlkem1024.mem";
  parameter INPUT_FIXTURE_FILE="mlkem1024_input.mem";
  parameter EXPECTED_FIXTURE_FILE="mlkem1024_expected.mem";

  localparam integer MAX_CASES=145, MAX_WORDS=131072;
  localparam integer PK_BYTES=(PARAMETER_SET==512) ? 800 : ((PARAMETER_SET==768) ? 1184 : 1568);
  localparam integer SK_BYTES=(PARAMETER_SET==512) ? 1632 : ((PARAMETER_SET==768) ? 2400 : 3168);
  localparam integer CT_BYTES=(PARAMETER_SET==512) ? 768 : ((PARAMETER_SET==768) ? 1088 : 1568);
  localparam [31:0] RAM_LIMIT=(32'h1 << (RAM_ADDR_BITS+2));
  localparam [31:0] STACK_TOP=RAM_LIMIT-32'd16, STACK_BOTTOM=STACK_TOP-STACK_BYTES;
  localparam [31:0] DEBUG_BASE=32'h50000000;
  localparam [31:0] STATUS_RUN=32'h4b415452, STATUS_PASS=32'h4b415450, STATUS_FAIL=32'h4b415446;
  localparam integer WAIT_CASE=0, ECHO_INPUT=1, WAIT_MEASURE=2, MEASURE=3, OUTPUT_DATA=4, WAIT_END=5;

  reg clk=0, resetn=0;
  wire trap;
  wire [31:0] status;
  wire [383:0] profile_words;
  reg [31:0] input_fixture[0:MAX_WORDS-1], expected_fixture[0:MAX_WORDS-1];
  integer input_offsets[0:MAX_CASES-1], expected_offsets[0:MAX_CASES-1];
  integer input_sizes[0:MAX_CASES-1], output_sizes[0:MAX_CASES-1];
  integer input_words_read=0, expected_words_read=0, fixture_cases=0;
  integer state=WAIT_CASE, completed_cases=0, current_case=-1;
  integer requested_words=0, pending_request=-1;
  integer stream_words=0, input_checks=0, output_checks=0;
  integer case_input_checks=0, case_output_checks=0;
  integer expected_input_bytes=0, expected_output_bytes=0;
  integer rdcycle_samples=0, calibration_samples=0;
  integer m_count[0:7], m_total=0;
  longint unsigned cycle_count=0, case_start_cycle=0, all_m_total=0;
  integer vector_file, scan_result, j, k, pos_in, pos_out, operation;
  integer current_input_offset, current_expected_offset;
  reg [31:0] file_word, empty_cycles, calibration_start, observed_empty;
  reg [31:0] algorithm_start, algorithm_cycles;
  reg [31:0] minimum_sp=STACK_TOP, algorithm_minimum_sp=STACK_TOP;
  reg stack_monitor_active=0, algorithm_active=0;
  wire [31:0] observed_sp=dut.cpu.picorv32_core.cpuregs[2];
  wire [31:0] observed_insn=dut.cpu.picorv32_core.pcpi_insn;
  wire rdcycle_executing=(dut.cpu.picorv32_core.cpu_state==8'b00100000) &&
                         dut.cpu.picorv32_core.instr_rdcycle;

  integer hls_starts=0, hls_dones=0, hash_calls=0, squeeze_calls=0;
  integer first_starts, first_dones, first_hash, first_squeeze;
  integer api_starts, api_dones, api_hash, api_squeeze;
  reg previous_start=0, previous_done=0;
  reg [31:0] first_busy, first_writes, first_reads;
  reg [31:0] api_busy, api_writes, api_reads;

  task automatic check_accelerator;
    begin
      if (dut.adapter_i.busy || dut.adapter_i.error || hls_starts!=hls_dones ||
          dut.adapter_i.starts_reg!==hls_starts || api_starts!=api_dones ||
          api_starts!=api_hash+api_squeeze || algorithm_cycles<api_busy ||
          (api_starts>0 && (api_busy==0 || api_writes==0 || api_reads==0)))
        $fatal(1,"KECCAK_FAIL metrics case=%0d starts=%0d done=%0d busy=%0d",current_case,api_starts,api_dones,api_busy);
    end
  endtask

  always #5 clk=~clk;
  mlkem1024_keccak_system #(
    .FIRMWARE_INIT_FILE(FIRMWARE_INIT_FILE), .RAM_ADDR_BITS(RAM_ADDR_BITS),
    .CPU_ENABLE_MUL(CPU_ENABLE_MUL), .CPU_ENABLE_FAST_MUL(CPU_ENABLE_FAST_MUL),
    .CPU_ENABLE_DIV(CPU_ENABLE_DIV)
  ) dut(.clk(clk),.resetn(resetn),.trap(trap),.status_out(status),.profile_words(profile_words));

  function automatic valid_address(input [31:0] address);
    valid_address=address<RAM_LIMIT || address[31:6]==DEBUG_BASE[31:6] ||
                  (address>=32'h50010000 && address<32'h50014000);
  endfunction

  task automatic require_state(input integer wanted, input integer event_code);
    begin
      if (state!=wanted)
        $fatal(1,"MLKEM_FAIL event=%h state=%0d expected=%0d case=%0d cycle=%0d",event_code,state,wanted,current_case,cycle_count);
      if (event_code!=32'h1ff && status!==STATUS_RUN)
        $fatal(1,"MLKEM_FAIL event without RUN status=%h",status);
      if (dut.debug_regs[1]!==0)
        $fatal(1,"MLKEM_FAIL firmware error=%h",dut.debug_regs[1]);
      if (event_code!=32'h100 && event_code!=32'h200 && event_code!=32'h1ff) begin
        if (dut.debug_regs[2]!==current_case ||
            dut.debug_regs[4]!==input_fixture[current_input_offset+5] ||
            dut.debug_regs[5]!==input_fixture[current_input_offset+1] ||
            dut.debug_regs[6]!==input_fixture[current_input_offset+4] ||
            dut.debug_regs[7]!==input_sizes[current_case])
          $fatal(1,"MLKEM_FAIL metadata changed during case=%0d",current_case);
      end
    end
  endtask

  task automatic check_stream(input integer is_output);
    reg [31:0] payload, wanted;
    integer byte_count, fixture_offset, b;
    begin
      byte_count=is_output ? output_sizes[current_case] : input_sizes[current_case];
      fixture_offset=is_output ? current_expected_offset+12 : current_input_offset+12;
      if (stream_words>=byte_count/4 || dut.debug_regs[12]!==stream_words || dut.debug_regs[14]!==4)
        $fatal(1,"MLKEM_FAIL stream shape case=%0d output=%0d word=%0d index=%h valid=%h",current_case,is_output,stream_words,dut.debug_regs[12],dut.debug_regs[14]);
      payload=dut.debug_regs[13];
      wanted=is_output ? expected_fixture[fixture_offset+stream_words] : input_fixture[fixture_offset+stream_words];
      for (b=0;b<4;b=b+1) begin
        if (payload[8*b+:8]!==wanted[8*b+:8])
          $fatal(1,"MLKEM_FAIL byte mismatch case=%0d output=%0d byte=%0d got=%h expected=%h",current_case,is_output,4*stream_words+b,payload[8*b+:8],wanted[8*b+:8]);
        if (is_output) begin output_checks=output_checks+1; case_output_checks=case_output_checks+1; end
        else begin input_checks=input_checks+1; case_input_checks=case_input_checks+1; end
      end
      stream_words=stream_words+1;
    end
  endtask

  task automatic check_metrics;
    begin
      if (rdcycle_samples!=2 || algorithm_active || algorithm_cycles<=empty_cycles ||
          dut.debug_regs[3]!==algorithm_cycles || dut.debug_regs[8]!==empty_cycles)
        $fatal(1,"MLKEM_FAIL cycle boundary case=%0d samples=%0d firmware=%h observed=%0d empty=%0d",current_case,rdcycle_samples,dut.debug_regs[3],algorithm_cycles,empty_cycles);
      if (dut.debug_regs[9]!==expected_fixture[current_expected_offset+11])
        $fatal(1,"MLKEM_FAIL API return case=%0d got=%h expected=%h",current_case,dut.debug_regs[9],expected_fixture[current_expected_offset+11]);
      // Validation-only cases legitimately execute no multiply instruction.
      if ((EXPECT_M==0 && m_total!=0) ||
          (EXPECT_M==1 && input_fixture[current_input_offset+5]<=4 && m_count[0]==0))
        $fatal(1,"MLKEM_FAIL unexpected M execution case=%0d expected=%0d total=%0d",current_case,EXPECT_M,m_total);
    end
  endtask

  initial begin
    if ((EXPECT_M!=0 && EXPECT_M!=1) ||
        (EXPECT_M==1 && (!(CPU_ENABLE_MUL || CPU_ENABLE_FAST_MUL) || !CPU_ENABLE_DIV)))
      $fatal(1,"MLKEM_FAIL invalid CPU/firmware configuration");
    for (j=0;j<8;j=j+1) m_count[j]=0;
    vector_file=$fopen(INPUT_FIXTURE_FILE,"r");
    if (!vector_file) $fatal(1,"MLKEM_FAIL missing input fixture");
    while (!$feof(vector_file)) begin
      scan_result=$fscanf(vector_file,"%h",file_word);
      if (scan_result==1) begin
        if (input_words_read>=MAX_WORDS || (^file_word)===1'bx)
          $fatal(1,"MLKEM_FAIL oversized/unknown input fixture");
        input_fixture[input_words_read]=file_word; input_words_read=input_words_read+1;
      end else if (!$feof(vector_file)) $fatal(1,"MLKEM_FAIL malformed input fixture");
    end
    $fclose(vector_file);
    vector_file=$fopen(EXPECTED_FIXTURE_FILE,"r");
    if (!vector_file) $fatal(1,"MLKEM_FAIL missing expected fixture");
    while (!$feof(vector_file)) begin
      scan_result=$fscanf(vector_file,"%h",file_word);
      if (scan_result==1) begin
        if (expected_words_read>=MAX_WORDS || (^file_word)===1'bx)
          $fatal(1,"MLKEM_FAIL oversized/unknown expected fixture");
        expected_fixture[expected_words_read]=file_word; expected_words_read=expected_words_read+1;
      end else if (!$feof(vector_file)) $fatal(1,"MLKEM_FAIL malformed expected fixture");
    end
    $fclose(vector_file);
    if (input_words_read<8 || expected_words_read<8) $fatal(1,"MLKEM_FAIL truncated header");
    fixture_cases=input_fixture[3];
    if (EXPECTED_CASES<1 || EXPECTED_CASES>MAX_CASES || fixture_cases!=EXPECTED_CASES || input_fixture[4]!==input_words_read || expected_fixture[4]!==expected_words_read)
      $fatal(1,"MLKEM_FAIL fixture size/case count mismatch");
    for (j=0;j<8;j=j+1)
      if (j!=4 && input_fixture[j]!==expected_fixture[j]) $fatal(1,"MLKEM_FAIL header mismatch word=%0d",j);
    if (input_fixture[0]!==32'h3254414b || input_fixture[1]!==1 || input_fixture[2]!==PARAMETER_SET ||
        input_fixture[5]!==0 || input_fixture[6]!==0 || input_fixture[7]!==0)
      $fatal(1,"MLKEM_FAIL invalid header");
    pos_in=8; pos_out=8;
    for (j=0;j<fixture_cases;j=j+1) begin
      if (pos_in+12>input_words_read || pos_out+12>expected_words_read)
        $fatal(1,"MLKEM_FAIL truncated metadata case=%0d",j);
      input_offsets[j]=pos_in; expected_offsets[j]=pos_out;
      for (k=0;k<11;k=k+1)
        if (input_fixture[pos_in+k]!==expected_fixture[pos_out+k])
          $fatal(1,"MLKEM_FAIL metadata mismatch case=%0d word=%0d",j,k);
      if (input_fixture[pos_in]!==j || input_fixture[pos_in+11]!==0 ||
          input_fixture[pos_in+5]<1 || input_fixture[pos_in+5]>6)
        $fatal(1,"MLKEM_FAIL invalid case identity/operation case=%0d",j);
      for (k=6;k<11;k=k+1)
        if (input_fixture[pos_in+k]>4096 || input_fixture[pos_in+k]%4!=0)
          $fatal(1,"MLKEM_FAIL invalid payload size case=%0d word=%0d",j,k);
      case (input_fixture[pos_in+5])
        1: if (input_fixture[pos_in+6]!==32 || input_fixture[pos_in+7]!==32 || input_fixture[pos_in+8]!==0 || input_fixture[pos_in+9]!==PK_BYTES || input_fixture[pos_in+10]!==SK_BYTES) $fatal(1,"MLKEM_FAIL KeyGen shape");
        2: if (input_fixture[pos_in+6]!==PK_BYTES || input_fixture[pos_in+7]!==32 || input_fixture[pos_in+8]!==0 || input_fixture[pos_in+9]!==CT_BYTES || input_fixture[pos_in+10]!==32) $fatal(1,"MLKEM_FAIL Encaps shape");
        3: if (input_fixture[pos_in+6]!==SK_BYTES || input_fixture[pos_in+7]!==CT_BYTES || input_fixture[pos_in+8]!==0 || input_fixture[pos_in+9]!==32 || input_fixture[pos_in+10]!==0) $fatal(1,"MLKEM_FAIL Decaps shape");
        4: if (input_fixture[pos_in+6]!==32 || input_fixture[pos_in+7]!==32 || input_fixture[pos_in+8]!==CT_BYTES || input_fixture[pos_in+9]!==32 || input_fixture[pos_in+10]!==0) $fatal(1,"MLKEM_FAIL seeded Decaps shape");
        5: if (input_fixture[pos_in+6]!==PK_BYTES || input_fixture[pos_in+7]!==0 || input_fixture[pos_in+8]!==0 || input_fixture[pos_in+9]!==0 || input_fixture[pos_in+10]!==0) $fatal(1,"MLKEM_FAIL public-key check shape");
        6: if (input_fixture[pos_in+6]!==SK_BYTES || input_fixture[pos_in+7]!==0 || input_fixture[pos_in+8]!==0 || input_fixture[pos_in+9]!==0 || input_fixture[pos_in+10]!==0) $fatal(1,"MLKEM_FAIL secret-key check shape");
      endcase
      if (expected_fixture[pos_out+11]!==0 && expected_fixture[pos_out+11]!==32'hfffffffc && expected_fixture[pos_out+11]!==32'hfffffffb)
        $fatal(1,"MLKEM_FAIL unsupported expected API return case=%0d",j);
      input_sizes[j]=input_fixture[pos_in+6]+input_fixture[pos_in+7]+input_fixture[pos_in+8];
      output_sizes[j]=input_fixture[pos_in+9]+input_fixture[pos_in+10];
      expected_input_bytes=expected_input_bytes+input_sizes[j];
      expected_output_bytes=expected_output_bytes+output_sizes[j];
      pos_in=pos_in+12+input_sizes[j]/4; pos_out=pos_out+12+output_sizes[j]/4;
      if (pos_in>input_words_read || pos_out>expected_words_read) $fatal(1,"MLKEM_FAIL truncated payload case=%0d",j);
    end
    if (pos_in!=input_words_read || pos_out!=expected_words_read) $fatal(1,"MLKEM_FAIL trailing fixture data");
    $display("MLKEM_HEADER,index,dataset,vsId,tgId,tcId,op,return_code,raw_cycles,empty_cycles,input_bytes,output_bytes,m_total,mul,mulh,mulhsu,mulhu,div,divu,rem,remu,min_sp");
    $display("MLKEM_START cases=%0d ram_bytes=%0d stack_bytes=%0d clock_mhz=100 mul=%0d fast_mul=%0d div=%0d expect_m=%0d",fixture_cases,RAM_LIMIT,STACK_BYTES,CPU_ENABLE_MUL,CPU_ENABLE_FAST_MUL,CPU_ENABLE_DIV,EXPECT_M);
    repeat (32) @(negedge clk);
    resetn=1;
  end

  // A host response at the opposite clock edge cannot race CPU/MMIO writes.
  // Only the two dedicated mailbox registers are driven by the testbench.
  always @(negedge clk) begin
    if (resetn && pending_request>=0) begin
      dut.debug_regs[10]=input_fixture[pending_request];
      dut.debug_regs[11]=pending_request+1;
      pending_request=-1;
    end
  end

  always @(posedge clk) begin
    if (resetn) begin
      cycle_count=cycle_count+1;
      if (dut.adapter_i.hls_i.ap_start && !previous_start) begin
        if (!algorithm_active) $fatal(1,"KECCAK_FAIL hardware start outside API");
        hls_starts=hls_starts+1;
        case (dut.adapter_i.command_shadow)
          0: hash_calls=hash_calls+1;
          1: squeeze_calls=squeeze_calls+1;
          default: $fatal(1,"KECCAK_FAIL unexpected command");
        endcase
      end
      if (dut.adapter_i.hls_i.ap_done && !previous_done) begin
        if (!algorithm_active) $fatal(1,"KECCAK_FAIL hardware done outside API");
        hls_dones=hls_dones+1;
      end
      previous_start=dut.adapter_i.hls_i.ap_start;
      previous_done=dut.adapter_i.hls_i.ap_done;
      if (dut.adapter_i.error) $fatal(1,"KECCAK_FAIL adapter error");
      if (cycle_count-case_start_cycle>=TIMEOUT_CYCLES)
        $fatal(1,"MLKEM_FAIL timeout cycle=%0d case=%0d state=%0d pc=%h sp=%h",cycle_count,current_case,state,dut.cpu.picorv32_core.reg_pc,observed_sp);
      if (trap!==1'b0) $fatal(1,"MLKEM_FAIL CPU trap=%b pc=%h",trap,dut.cpu.picorv32_core.reg_pc);
      if (status===STATUS_FAIL) $fatal(1,"MLKEM_FAIL firmware error=%h",dut.debug_regs[1]);
      if (dut.c_arvalid===1'b1 && valid_address(dut.c_araddr)!==1'b1) $fatal(1,"MLKEM_FAIL out-of-map read %h",dut.c_araddr);
      if (dut.c_awvalid===1'b1 && valid_address(dut.c_awaddr)!==1'b1) $fatal(1,"MLKEM_FAIL out-of-map write %h",dut.c_awaddr);
      if (status===STATUS_RUN) stack_monitor_active=1;
      if (stack_monitor_active) begin
        if ((^observed_sp)===1'bx || observed_sp<STACK_BOTTOM || observed_sp>STACK_TOP || observed_sp[3:0]!=0)
          $fatal(1,"MLKEM_FAIL invalid stack pointer %h case=%0d",observed_sp,current_case);
        if (observed_sp<minimum_sp) minimum_sp=observed_sp;
        if (algorithm_active && observed_sp<algorithm_minimum_sp) algorithm_minimum_sp=observed_sp;
      end
      if (rdcycle_executing) begin
        if (state==MEASURE) begin
          if (rdcycle_samples==0) begin
            algorithm_start=dut.cpu.picorv32_core.count_cycle[31:0];
            algorithm_active=1; algorithm_minimum_sp=observed_sp;
            first_starts=hls_starts; first_dones=hls_dones;
            first_hash=hash_calls; first_squeeze=squeeze_calls;
            first_busy=dut.adapter_i.cycles_reg;
            first_writes=dut.adapter_i.writes_reg; first_reads=dut.adapter_i.reads_reg;
          end else if (rdcycle_samples==1) begin
            algorithm_cycles=dut.cpu.picorv32_core.count_cycle[31:0]-algorithm_start;
            algorithm_active=0;
            api_starts=hls_starts-first_starts; api_dones=hls_dones-first_dones;
            api_hash=hash_calls-first_hash; api_squeeze=squeeze_calls-first_squeeze;
            api_busy=dut.adapter_i.cycles_reg-first_busy;
            api_writes=dut.adapter_i.writes_reg-first_writes;
            api_reads=dut.adapter_i.reads_reg-first_reads;
            check_accelerator();
          end else $fatal(1,"MLKEM_FAIL extra rdcycle in algorithm");
          rdcycle_samples=rdcycle_samples+1;
        end else if (state==WAIT_CASE && completed_cases==0 && calibration_samples<2) begin
          if (calibration_samples==0) calibration_start=dut.cpu.picorv32_core.count_cycle[31:0];
          else observed_empty=dut.cpu.picorv32_core.count_cycle[31:0]-calibration_start;
          calibration_samples=calibration_samples+1;
        end else $fatal(1,"MLKEM_FAIL rdcycle outside measurement window");
      end
      if (dut.cpu.picorv32_core.pcpi_valid && dut.cpu.picorv32_core.pcpi_int_ready) begin
        if (observed_insn[31:25]!==7'b0000001 || observed_insn[6:0]!==7'b0110011 || (^observed_insn[14:12])===1'bx)
          $fatal(1,"MLKEM_FAIL unexpected PCPI instruction %h",observed_insn);
        operation=observed_insn[14:12]; all_m_total=all_m_total+1;
        if (EXPECT_M==0) $fatal(1,"MLKEM_FAIL RV32I executed M instruction");
        if (algorithm_active) begin m_count[operation]=m_count[operation]+1; m_total=m_total+1; end
      end
      if (dut.local_write_commit && dut.commit_addr[31:6]==DEBUG_BASE[31:6]) begin
        if (dut.commit_strb!==4'b1111 || dut.commit_addr[1:0]!==0) $fatal(1,"MLKEM_FAIL partial/unaligned debug write");
        if (dut.commit_addr==DEBUG_BASE+40 || dut.commit_addr==DEBUG_BASE+44) $fatal(1,"MLKEM_FAIL CPU wrote host mailbox");
        if (algorithm_active) $fatal(1,"MLKEM_FAIL debug write inside timed algorithm");
        if (dut.commit_addr==DEBUG_BASE+60) begin
          case (dut.commit_data)
            32'h200: begin
              require_state(WAIT_CASE,32'h200);
              if (pending_request!=-1 || requested_words>=input_words_read || completed_cases>=fixture_cases ||
                  dut.debug_regs[12]!==requested_words ||
                  requested_words>=input_offsets[completed_cases]+12+input_sizes[completed_cases]/4)
                $fatal(1,"MLKEM_FAIL invalid mailbox request requested=%0d index=%h case=%0d",requested_words,dut.debug_regs[12],completed_cases);
              pending_request=requested_words; requested_words=requested_words+1;
            end
            32'h100: begin
              require_state(WAIT_CASE,32'h100);
              if (completed_cases>=fixture_cases || pending_request!=-1 || !stack_monitor_active || calibration_samples!=2)
                $fatal(1,"MLKEM_FAIL premature case begin");
              current_case=completed_cases; current_input_offset=input_offsets[current_case]; current_expected_offset=expected_offsets[current_case];
              if (requested_words!=current_input_offset+12+input_sizes[current_case]/4 ||
                  dut.debug_regs[2]!==current_case || dut.debug_regs[4]!==input_fixture[current_input_offset+5] ||
                  dut.debug_regs[5]!==input_fixture[current_input_offset+1] || dut.debug_regs[6]!==input_fixture[current_input_offset+4] ||
                  dut.debug_regs[7]!==input_sizes[current_case] || dut.debug_regs[8]!==observed_empty || observed_empty==0 ||
                  dut.debug_regs[3]!==0 || dut.debug_regs[9]!==0)
                $fatal(1,"MLKEM_FAIL invalid case metadata/calibration case=%0d",current_case);
              empty_cycles=dut.debug_regs[8]; case_input_checks=0; case_output_checks=0;
              stream_words=0; rdcycle_samples=0; m_total=0;
              for (j=0;j<8;j=j+1) m_count[j]=0;
              state=ECHO_INPUT;
            end
            32'h201: begin
              require_state(ECHO_INPUT,32'h201); check_stream(0);
              if (stream_words==input_sizes[current_case]/4) begin stream_words=0; state=WAIT_MEASURE; end
            end
            32'h108: begin
              require_state(WAIT_MEASURE,32'h108);
              if (case_input_checks!=input_sizes[current_case] || rdcycle_samples!=0 || algorithm_active)
                $fatal(1,"MLKEM_FAIL premature/nested measurement case=%0d",current_case);
              state=MEASURE;
            end
            32'h109: begin
              require_state(MEASURE,32'h109);
              if (rdcycle_samples!=2 || algorithm_active || algorithm_cycles<=empty_cycles)
                $fatal(1,"MLKEM_FAIL missing/invalid rdcycle pair case=%0d",current_case);
              state=output_sizes[current_case]==0 ? WAIT_END : OUTPUT_DATA;
            end
            32'h202: begin
              require_state(OUTPUT_DATA,32'h202); check_metrics(); check_stream(1);
              if (stream_words==output_sizes[current_case]/4) begin stream_words=0; state=WAIT_END; end
            end
            32'h105: begin
              require_state(WAIT_END,32'h105); check_metrics();
              if (case_input_checks!=input_sizes[current_case] || case_output_checks!=output_sizes[current_case])
                $fatal(1,"MLKEM_FAIL incomplete case bytes case=%0d",current_case);
              $display("MLKEM_ROW,%0d,%0d,%0d,%0d,%0d,%0d,%0d,%0d,%0d,%0d,%0d,%0d,%0d,%0d,%0d,%0d,%0d,%0d,%0d,%0d,0x%08h",
                current_case,input_fixture[current_input_offset+1],input_fixture[current_input_offset+2],input_fixture[current_input_offset+3],input_fixture[current_input_offset+4],input_fixture[current_input_offset+5],$signed(dut.debug_regs[9]),
                algorithm_cycles,empty_cycles,case_input_checks,case_output_checks,m_total,m_count[0],m_count[1],m_count[2],m_count[3],m_count[4],m_count[5],m_count[6],m_count[7],algorithm_minimum_sp);
              check_accelerator();
              $display("KECCAK_ROW,%0d,%0d,%0d,%0d,%0d,%0d,%0d,%0d",current_case,api_starts,api_dones,api_hash,api_squeeze,api_busy,api_writes,api_reads);
              completed_cases=completed_cases+1; state=WAIT_CASE; case_start_cycle=cycle_count;
            end
            32'h1ff: begin
              require_state(WAIT_CASE,32'h1ff);
              if (completed_cases!=fixture_cases || input_checks!=expected_input_bytes || output_checks!=expected_output_bytes ||
                  requested_words!=input_words_read || pending_request!=-1 || status!==STATUS_PASS || algorithm_active)
                $fatal(1,"MLKEM_FAIL premature completion cases=%0d inputs=%0d outputs=%0d requests=%0d status=%h",completed_cases,input_checks,output_checks,requested_words,status);
              $display("MLKEM_PASS cases=%0d input_bytes=%0d output_bytes=%0d cpu_mul=%0d cpu_fast_mul=%0d cpu_div=%0d expect_m=%0d cycles=%0d all_m=%0d min_sp=0x%08h stack_used=%0d",
                completed_cases,input_checks,output_checks,CPU_ENABLE_MUL,CPU_ENABLE_FAST_MUL,CPU_ENABLE_DIV,EXPECT_M,cycle_count,all_m_total,minimum_sp,STACK_TOP-minimum_sp);
              check_accelerator();
              $display("KECCAK_PASS cases=%0d starts=%0d done=%0d hash=%0d squeeze=%0d",completed_cases,hls_starts,hls_dones,hash_calls,squeeze_calls);
              $finish;
            end
            default: $fatal(1,"MLKEM_FAIL unknown event=%h",dut.commit_data);
          endcase
        end
      end
    end
  end
endmodule
