hongpengWu/mlkem-polymul-rv32i-fpga/(commit log)

2026-09-21 Publish reproducible ML-KEM PolyMul RV32I FPGA research sources
    [FINAL_MANIFEST.csv, REDACTION_MANIFEST.csv, SOURCE_MANIFEST.csv, firmware_build.csv, hls_config.cfg]
2026-09-21 Correct publication status and revise technical documentation
    [FINAL_MANIFEST.csv]
2026-09-22 Organize final PYNQ-Z2 design for Vivado 2024.2
    Preserve RTL, HLS, firmware and required testbench bytes; remove historical experiments and reports. Add a portable Vivado project, matched BIT/LTX artifacts, source integrity checks and current validation documentation.
    [FINAL_MANIFEST.csv, REDACTION_MANIFEST.csv, SOURCE_MANIFEST.csv, firmware_build.csv, source_integrity.csv]
2026-09-23 Add CPU baseline and competition roadmap
    [build_inputs.csv, cpu_benchmark_rows.csv, instruction_cycles.csv, source_changes.csv]
2026-09-25 Add ML-KEM-512 profiling and standard BaseMul HLS
    Keep the original branches unchanged while making 24-2hp the maintained Vivado 2024.2 branch. Archive official CPU baseline evidence, interface audits, Vitis HLS synthesis results, and the exported K=2 cached BaseMul IP; remove generated Vivado and simulation caches.
    [cases.csv, completed_rows.csv, hls_config.cfg, phases.csv, summary.csv]
2026-09-25 Remove legacy accelerator tree and retain current baseline
    [build_inputs.csv, hls_config.cfg, instruction_cycles.csv, source_changes.csv, source_integrity.csv]
2026-09-26 Add RV32IM accelerator official KAT results
    [cases.csv]
2026-09-26 Validate ML-KEM-768 CPU KAT and add resumable parameter-set regression
    [cases.csv]
2026-09-26 Complete ML-KEM-1024 CPU KAT evidence
    [cases.csv]
2026-09-27 Connect PicoRV32 to K4 Keccak and verify CPU smoke and call profile
    [calls.csv]
2026-09-27 Integrate K4 hardware FIPS202 and validate official RTL pilot
    [cases.csv]
2026-09-27 Record complete K4 hardware KAT and 3.803x end-to-end speedup
    [cases.csv]
2026-10-04 Close K4 internal timing and default development to KAT subsets
    [cases.csv]
2026-10-04 feat: complete K4 PYNQ-Z2 pre-board signoff
    [recovery_moves.tsv]
2026-10-04 test: archive final K4 candidate 145-case pre-board validation
    [cases.csv]
2026-10-04 feat: add verified K4 PYNQ AXI overlay and Jupyter demo
    [lut_recovery_moves.tsv]
2026-10-29 board: include K4 release bitstream
